ryanstevensmith/locust_hardware/IC_002 - Acoustic Nb-IoT Daughter Board/IC_002 - Acoustic Nb-IoT Daughter Board - Release v3.0/back.png

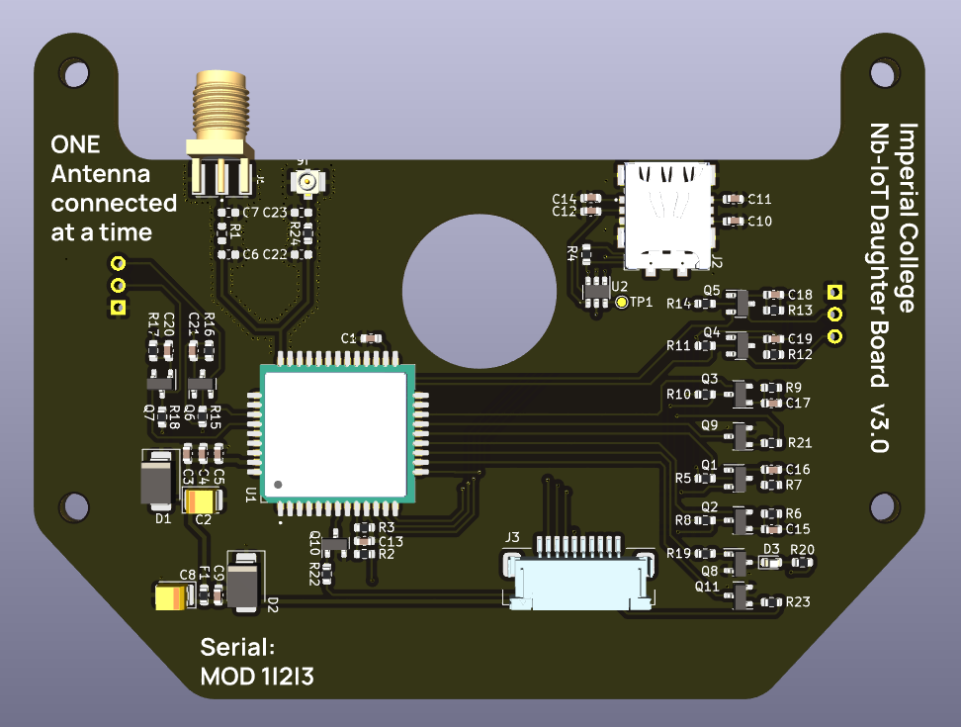
IC_002 - Acoustic Nb-IoT Daughter Board/IC_002 - Acoustic Nb-IoT Daughter Board - Release v3.0/back.png
