ryanstevensmith/locust_hardware/IC_001 - Low Cost Audio Sensor/IC_001 - Low Cost Audio Sensor - Release v3.0/manufacturing files/IC_001 - Low Cost Audio Sensor - BoM EXT - v3.0.csv

Reference | Qty | Value | Footprint | LCSC | MF | MP | Digi-Key
C1,C4,C7,C8,C13,C22,C23,C24,C25,C27,C28 | 11 | 100nF | Capacitor_SMD:C_0402_1005Metric | C1525 | Murata Electronics | GRM155R71C104KA88J | 490-6328-2-ND
C2,C3,C5,C6,C16,C17,C18,C20,C21,C26 | 10 | 10uF | Capacitor_Tantalum_SMD:CP_EIA-3216-18_Kemet-A | C128254 | KEMET | T491A106K010AT | 399-3684-2-ND
C14 | 1 | 10n | Capacitor_SMD:C_0402_1005Metric | C1524 | Murata Electronics | GRM155R71C103KA01D | 490-1313-2-ND
C15 | 1 | 2u2 | Capacitor_SMD:C_0402_1005Metric | C193620 | Murata Electronics | GRM155R61E225ME11D | 490-12704-2-ND
D1,D2,D9,D10,D11,D12,D13,D14,D15,D16,D17,D18,D19,D20,D21,D22,D23,D24,D25,D26,D27,D28,D29,D30,D31,D32,D33,D34,D35,D36,D37,D38,D39,D40,D41,D49,D50,D51,D52,D53 | 40 | SK6806 - j | SR_LED:LED_SK6805_PLCC4_2.4x2.7mm_P1.3mm | C2909056 |  | SK6805MICRO-J
D3 | 1 | BZT52C6V8LP-7 | SR_Package_DFN_QFN:X1-DFN1006-2 | C460796 | Diodes Incorporated | BZT52C6V8LP-7 | BZT52C6V8LPDITR-ND
D4,D5,D6,D7,D8,D42,D43,D44,D45,D46,D47,D48 | 12 | ESD761 | SR_Package_SON:Texas_DPY0002A_0.6x1mm_P0.65mm | C20345399 | Texas Instruments | ESD761DPYRQ1 | 296-ESD761DPYRQ1TR-ND
F1,F2 | 2 | 1A/6V | Fuse:Fuse_0603_1608Metric | C516069 | Littelfuse Inc. | 0603L100SLYR | F5761TR-ND
J1 | 1 | USB4115-03-C | SR_Connectors:USB_C_Receptacle_GCT_USB4115-03-C | C5250720 | GCT | USB4115-03-C | 2073-USB4115-03-CTR-ND
J2 | 1 | JST_SH | SR_Connectors:JST_SH_BM05B-SRSS-TB_1x05-1MP_P1.00mm_Vertical | C160391 | JST | BM05B-SRSS-TB | 455-BM05B-SRSS-TBTR-ND
J3 | 1 | 53261-0371 | Connector_Molex:Molex_PicoBlade_53261-0371_1x03-1MP_P1.25mm_Horizontal | C293630 | Molex | 532610371 | WM7621TR-ND
J4 | 1 | 503398-1892 | SR_Connectors:503398-1892 | C428492 | Molex | 5033981892 | WM11190TR-ND
J6 | 1 | 52207-1060 | SR_Connectors:52207-1060 | C3168739 | Molex | 0522071060 | WM3753TR-ND
J7,J8 | 2 | JST_SH | SR_Connectors:JST_SH_SM04B-SRSS-TB_1x04-1MP_P1.00mm_Horizontal | C160404 | JST | SM04B-SRSS-TB | 455-SM04B-SRSS-TBTR-ND
L1,L3,L4,L6 | 4 | BLM15PX221SN1D | Inductor_SMD:L_0402_1005Metric | C160973 | Murata Electronics | BLM15PX221SN1D | 490-11021-2-ND
L2,L5 | 2 | 2.2uH | Inductor_SMD:L_Bourns-SRN4018 | C135262 | Bourns Inc. | SRN4018-2R2M | SRN4018-2R2MTR-ND
Q3 | 1 | DMP3013SFV | Package_SON:Diodes_PowerDI3333-8 | C264098 | Diodes Incorporated | DMP3013SFV-7 | DMP3013SFV-7DITR-ND
R1,R4,R6,R7,R9,R10,R12,R13,R14,R18,R19,R27 | 12 | 10K | Resistor_SMD:R_0402_1005Metric | C25744 | Vishay Dale | CRCW040210K0FKED | 541-10.0KLTR-ND
R2,R3 | 2 | 0R | Resistor_SMD:R_0402_1005Metric | C17168 | Vishay Dale | RCG04020000Z0ED | 541-1887-2-ND
R5,R32,R33 | 3 | 47K | Resistor_SMD:R_0402_1005Metric | C25792 | Vishay Dale | CRCW040247K0FKEDC | 541-3966-2-ND
R8,R11,R22 | 3 | 1M | Resistor_SMD:R_0402_1005Metric | C26087 | Vishay Dale | CRCW04021M00FKED | 541-1.00MLTR-ND
R15,R17 | 2 | 180K | Resistor_SMD:R_0402_1005Metric | C25541 | Vishay Dale | CRCW0402180KFKEDC | 541-4071-2-ND
R16 | 1 | 1M6 | Resistor_SMD:R_0402_1005Metric | C57065 | Vishay Dale | CRCW04021M60FKED | 541-1.60MLTR-ND
R23,R24 | 2 | 5K1 | Resistor_SMD:R_0402_1005Metric | C25941 | Vishay Dale | CRCW04025K10FKED | 541-5.10KLTR-ND
R25,R26 | 2 | 22R | Resistor_SMD:R_0402_1005Metric | C25152 | Vishay Dale | CRCW040222R0FKED | 541-22.0LTR-ND
R28 | 1 | 4K7 | Resistor_SMD:R_0402_1005Metric | C25900 | Vishay Dale | CRCW04024K70FKEDC | 541-3963-2-ND
R29 | 1 | 1M8 | Resistor_SMD:R_0402_1005Metric | C473021 | Vishay Dale | CRCW04021M80FKEDC | 541-4800-2-ND
R34 | 1 | 220R | Resistor_SMD:R_0402_1005Metric | C25151 | Vishay Dale | CRCW0402220RFKEDC | 541-4064-2-ND
SW1,SW2 | 2 | SW_Push | Button_Switch_SMD:SW_SPST_B3U-1000P | C231329 | Omron | B3U-1000P | SW1020TR-ND
SW4,SW5,SW6,SW7,SW8 | 5 | TL3305AF260QG | SR_Button:SW_SPST_TL3305A | C2886902 | E-Switch | TL3305AF260QG | EG5353TR-ND
U1 | 1 | BQ21080 | SR_Package_BGA:Texas_DSBGA-8-1.6mmx1mm_P0.4mm | C6869615 | Texas Instruments | BQ21080YBGR | 296-BQ21080YBGRTR-ND
U2 | 1 | BQ27427 | SR_Package_BGA:Texas_DSBGA-9-1.6mmx1.6_P0.5mm | C6075475 | Texas Instruments | BQ27427YZFR | 296-BQ27427YZFRTR-ND
U3 | 1 | ESP32-S3-WROOM-1 | RF_Module:ESP32-S3-WROOM-1 | C2913202 | Espressif Systems | ESP32-S3-WROOM-1-N16R8 | 5407-ESP32-S3-WROOM-1-N16R8TR-ND
U4,U10 | 2 | TPS63000 | Package_SON:Texas_DRC0010J_ThermalVias | C24966 | Texas Instruments | TPS63000DRCR | 296-19641-2-ND
U5 | 1 | SPV0142LR5H | SR_Sensor_Audio:SPV0142LR5H-1 | C45062176 | Syntiant | SPV0142LR5H-1 | SPV0142LR5HTR-ND
U11 | 1 | TLV320ADC3101IRGER | Package_DFN_QFN:QFN-24-1EP_4x4mm_P0.5mm_EP2.8x2.8mm | C162409 | Texas Instruments | TLV320ADC3101IRGER | 296-39263-2-ND
U13 | 1 | OPA1671IDBVR | Package_TO_SOT_SMD:TSOT-23-5 | C1849409 | Texas Instruments | OPA1671IDBVR | 296-OPA1671IDBVRTR-ND
