ryanstevensmith/locust_hardware/IC_002 - Acoustic Nb-IoT Daughter Board/IC_002 - Acoustic Nb-IoT Daughter Board - Release v3.0/manufacturing files/IC_002 - Acoustic Nb-IoT Daughter Board - BoM EXT - v3.0.csv

Qty | Reference | Value | Footprint | Datasheet | MF | PN | DigiKey
1 | C1 | 2.2uF | Capacitor_SMD:C_0603_1608Metric | ~ | Murata Electronics | GRM188C71C225KE11D | 490-12731-2-ND
2 | C2,C8 | 100uF | Capacitor_Tantalum_SMD:CP_EIA-3528-21_Kemet-B | ~ | KYOCERA AVX | TAJB107M006RNJ | 478-3877-2-ND
4 | C3,C9,C13,C14 | 100nF | Capacitor_SMD:C_0603_1608Metric | ~ | Murata Electronics | GCM188R71H104KA57J | 490-8020-2-ND
1 | C4 | 100pF | Capacitor_SMD:C_0603_1608Metric | ~ | Murata Electronics | GRM1885C1H101JA01D | 490-1427-2-ND
4 | C5,C10,C11,C12 | 22pF | Capacitor_SMD:C_0603_1608Metric | ~ | Murata Electronics | GRM1885C1H220JA01D | 490-1411-2-ND
7 | C15,C16,C17,C18,C19,C20,C21 | 1nF | Capacitor_SMD:C_0603_1608Metric | ~ | Murata Electronics | GCM188R71H102KA37D | 490-4777-2-ND
2 | D1,D2 | P6SMBJ5.0CA | Diode_SMD:D_SMB | https://diotec.com/request/datasheet/p6smbj65.pdf | Diotec | P6SMBJ5.0CA | 4878-P6SMBJ5.0CATR-ND
1 | D3 | Blue | LED_SMD:LED_0603_1608Metric | ~ | Kingbright | APTD1608VBC/D | 754-1804-2-ND
1 | F1 | 1A/32V | Fuse:Fuse_0603_1608Metric | ~ | Panasonic | P15124TR-ND | P15124TR-ND
1 | J1 | SMA | SR_Antenna:CON-SMA-EDGE-S | ~ | RF Solutions | CON-SMA-EDGE-S | CON-SMA-EDGE-S-ND
1 | J2 | 104224-0820 | SR_Connectors:MOLEX_104224-0820 |  | Molex | 104224-0820 | WM23749TR-ND
1 | J3 | 52207-1060 | SR_Connectors:52207-1060 | ~ | Molex | 52207-1060 | WM3753TR-ND
1 | J6 | U.FL | SR_Antenna:U.FL-R-SMT-1_1 | ~ | Hirose Electric Co Ltd | U.FL-R-SMT(10) | H9161TR-ND
11 | Q1,Q2,Q3,Q4,Q5,Q6,Q7,Q8,Q9,Q10,Q11 | BC817 | Package_TO_SOT_SMD:SOT-23 | https://www.onsemi.com/pub/Collateral/BC818-D.pdf | Nexperia | BC817-QR | 1727-BC817-QR-ND
1 | R2 | 21K | Resistor_SMD:R_0603_1608Metric | ~ | Vishay Dale | CRCW060321K0FKEA | 541-21.0KHTR-ND
9 | R3,R4,R5,R8,R10,R11,R14,R15,R18 | 10K | Resistor_SMD:R_0603_1608Metric | ~ | Vishay Dale | CRCW060310K0FKEA | 541-10.0KHTR-ND
7 | R6,R7,R9,R12,R13,R16,R17 | 4K7 | Resistor_SMD:R_0603_1608Metric | ~ | Vishay Dale | CRCW06034K70FKEAC | 541-5454-2-ND
5 | R19,R20,R21,R22,R23 | 1K | Resistor_SMD:R_0603_1608Metric | ~ | Vishay Dale | CRCW06031K00FKEA | 541-1.00KHTR-ND
1 | R24 | 0R | Resistor_SMD:R_0603_1608Metric | ~ | Vishay Dale | CRCW06030000Z0EA | 541-0.0GTR-ND
1 | U1 | BC65 | SR_RF_Module:BC65 | https://www.quectel.com/product/lpwa-bc65-nb-iot/ | Quectel | BC65PB-04-STD | 2958-BC65PB-04-STDTR-ND
1 | U2 | SRV05-4HTG-D | SR_Package_SOT:TSOT-23-6 | https://www.littelfuse.com/assetdocs/littelfuse-tvs-diode-array-srv05-4htg-d-datasheet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 | LittleFuse | SRV05-4HTG-D | SRV05-4HTG-DTR-ND
