ryanstevensmith/locust_hardware/IC_001 - Low Cost Audio Sensor/IC_001 - Low Cost Audio Sensor - Release v3.0/back.png

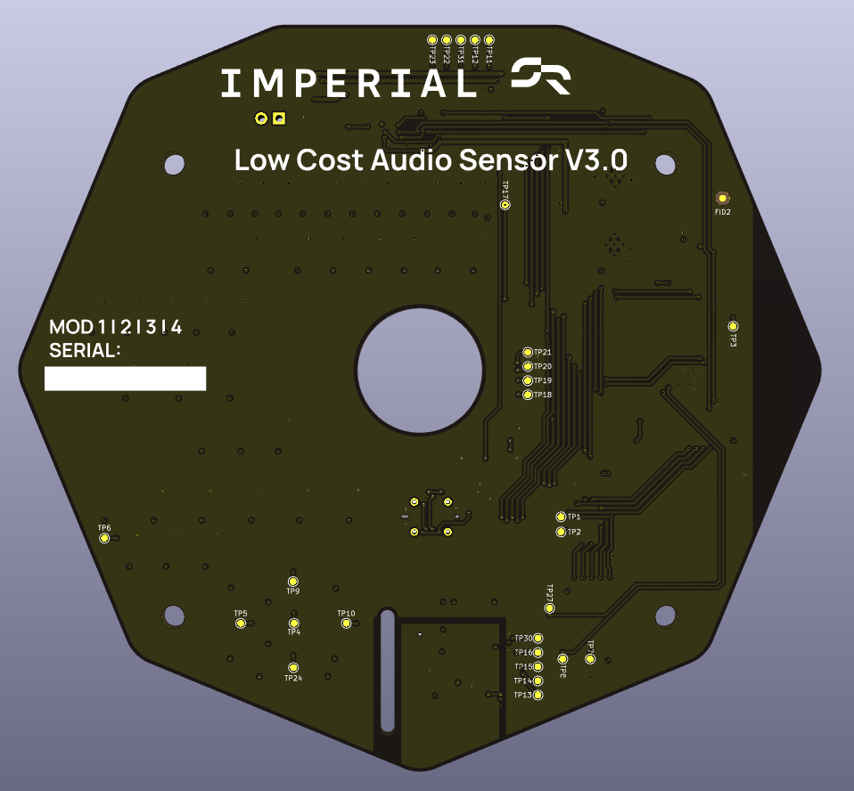
IC_001 - Low Cost Audio Sensor/IC_001 - Low Cost Audio Sensor - Release v3.0/back.png
