ryanstevensmith/locust_hardware/IC_001 - Low Cost Audio Sensor/IC_001 - Low Cost Audio Sensor - Release v3.0/front.png

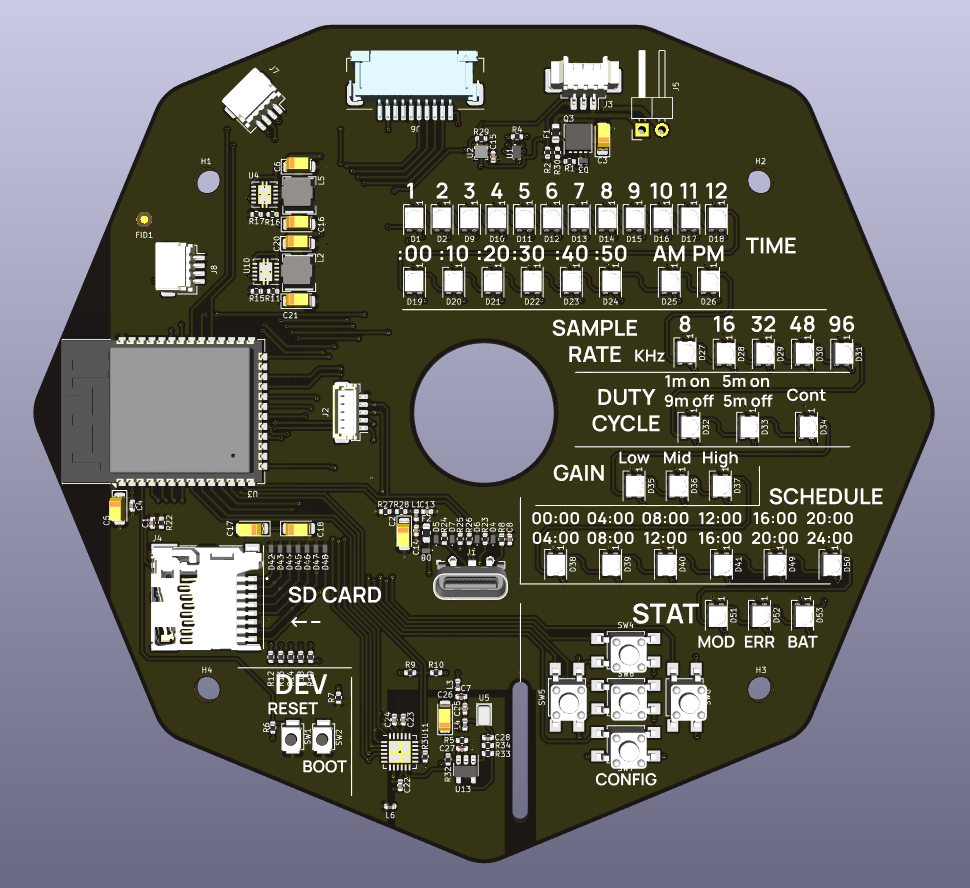
IC_001 - Low Cost Audio Sensor/IC_001 - Low Cost Audio Sensor - Release v3.0/front.png
