ryanstevensmith/locust_hardware/IC_001 - Low Cost Audio Sensor/IC_001 - Low Cost Audio Sensor - Release v3.0/IC_001 - Low Cost Audio Sensor - v3.0.step

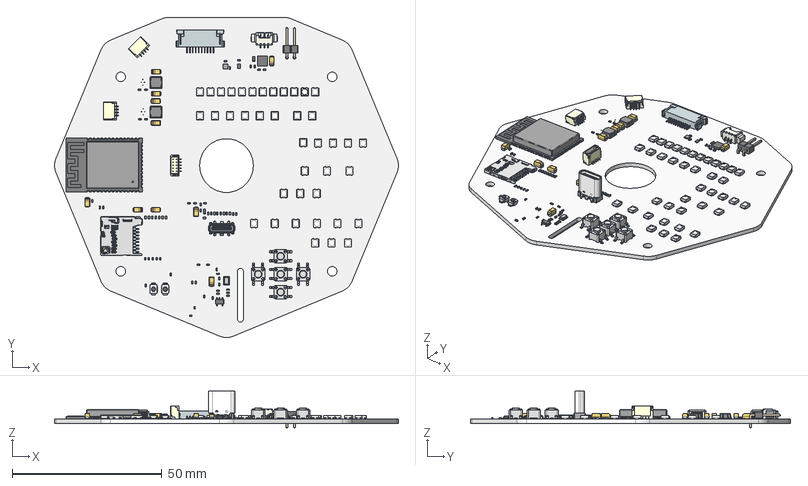
[picture p9: CAD file, 2026-10-24]
IC_001 - Low Cost Audio Sensor/IC_001 - Low Cost Audio Sensor - Release v3.0/IC_001 - Low Cost Audio Sensor - v3.0.step
115.0 x 107.0 x 12.3 mm
R_0402_1005Metric x 31
SPV0142LR5H
TL3305AFxxxxG x 5
DOUT x 40
DIN x 40
VSS x 40
VDD x 40
Texas_DPY0002A_X1SON-2 x 12
LDF
SM04B-SRSS-TB(LF)(SN) x 2
BM05B-SRSS-TB(LF)(SN)
C_0402_1005Metric x 13
USB4115-03-C_PART1
USB4115-03-C_PART2
USB4115-03-C_PART3
USB4115-03-C_PART4
USB4115-03-C_PART5
USB4115-03-C_PART6
USB4115-03-C_PART7
USB4115-03-C_PART8
USB4115-03-C_PART9
USB4115-03-C_PART10
USB4115-03-C_PART11
USB4115-03-C_PART12
USB4115-03-C_PART13
USB4115-03-C_PART14
USB4115-03-C_PART15
USB4115-03-C_PART16
USB4115-03-C_PART17
USB4115-03-C_PART18
USB4115-03-C_PART19
USB4115-03-C_PART20
USB4115-03-C_PART21
USB4115-03-C_PART22
USB4115-03-C_PART23
USB4115-03-C_PART24
USB4115-03-C_PART25
USB4115-03-C_PART26
USB4115-03-C_PART27
USB4115-03-C_PART28
USB4115-03-C_PART29
USB4115-03-C_PART30
USB4115-03-C_PART31
USB4115-03-C_PART32
USB4115-03-C_PART33
USB4115-03-C_PART34
USB4115-03-C_PART35
USB4115-03-C_PART36
USB4115-03-C_PART37
USB4115-03-C_PART38
USB4115-03-C_PART39
USB4115-03-C_PART40
USB4115-03-C_PART41
USB4115-03-C_PART42
USB4115-03-C_PART43
USB4115-03-C_PART44
ESP32-S3-WROOM-1
PinHeader_1x02_P2.54mm_Horizontal
CP_EIA-3216-18_Kemet-A x 10
DSBGA8-YBG_TEX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
