ryanstevensmith/locust_hardware/IC_002 - Acoustic Nb-IoT Daughter Board/IC_002 - Acoustic Nb-IoT Daughter Board - Release v3.0/IC_002 - Acoustic Nb-IoT Daughter Board - v3.0.step

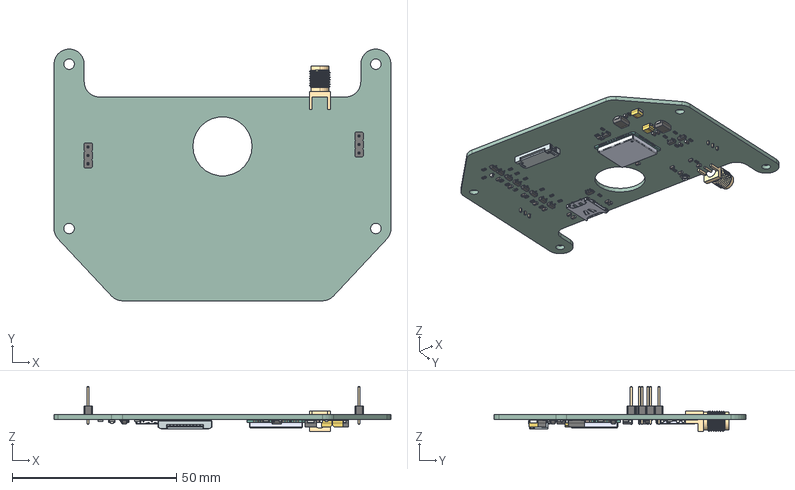
[picture p10: CAD file, 2026-10-24]
IC_002 - Acoustic Nb-IoT Daughter Board/IC_002 - Acoustic Nb-IoT Daughter Board - Release v3.0/IC_002 - Acoustic Nb-IoT Daughter Board - v3.0.step
102.5 x 76.6 x 13.8 mm
PinHeader_1x03_P2.54mm_Vertical x 2
R_0603_1608Metric x 24
SOT-23 x 11
C_0603_1608Metric x 21
Fuse_0603_1608Metric
D_SMB x 2
BC65
CON-SMA-EDGE-S
CP_EIA-3528-21_Kemet-B x 2
U.FL-R-SMT-1
TSOT-23-6
LED_0603_1608Metric
IC_002 - Acoustic Nb-IoT Daughter Board_PCB
