ryanstevensmith/locust_hardware/IC_001 - Low Cost Audio Sensor/IC_001 - Low Cost Audio Sensor - Release v1.0/IC_001 - Low Cost Audio Sensor - v1.0.step

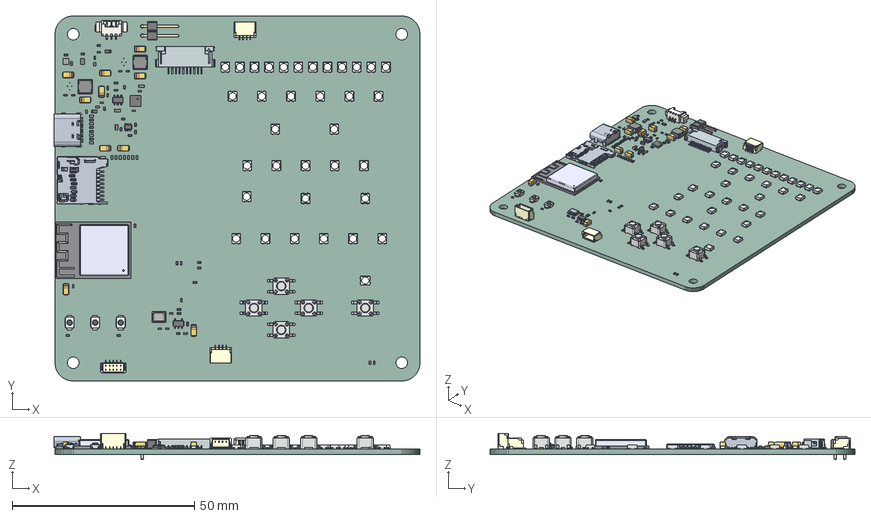
[picture p11: CAD file, 2026-10-24, an earlier design]
IC_001 - Low Cost Audio Sensor/IC_001 - Low Cost Audio Sensor - Release v1.0/IC_001 - Low Cost Audio Sensor - v1.0.step
100.3 x 100.0 x 7.25 mm
IC_001 - Low Cost Audio Sensor PCB
