ryanstevensmith/locust_hardware/IC_002 - Acoustic Nb-IoT Daughter Board/IC_002 - Acoustic Nb-IoT Daughter Board - Release v1.0/IC_002 - Acoustic Nb-IoT - v1.0.step

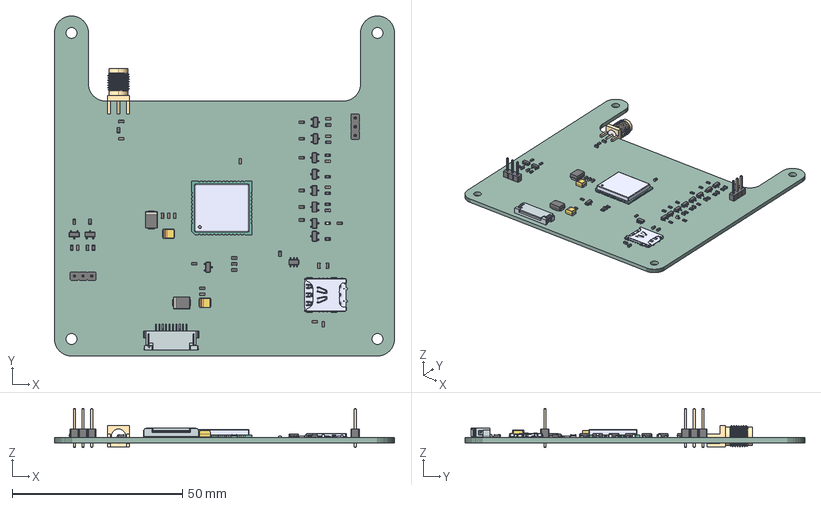
[picture p12: CAD file, 2026-10-24, an earlier design]
IC_002 - Acoustic Nb-IoT Daughter Board/IC_002 - Acoustic Nb-IoT Daughter Board - Release v1.0/IC_002 - Acoustic Nb-IoT - v1.0.step
100.0 x 100.0 x 11.5 mm
IC_002 - Acoustic Nb-IoT Daughter Board PCB
