ryanstevensmith/locust_hardware/IC_001 - Low Cost Audio Sensor/IC_001 - Low Cost Audio Sensor - Release v3.0/IC_001 - Low Cost Audio Sensor - Schematics - v3.0.pdf

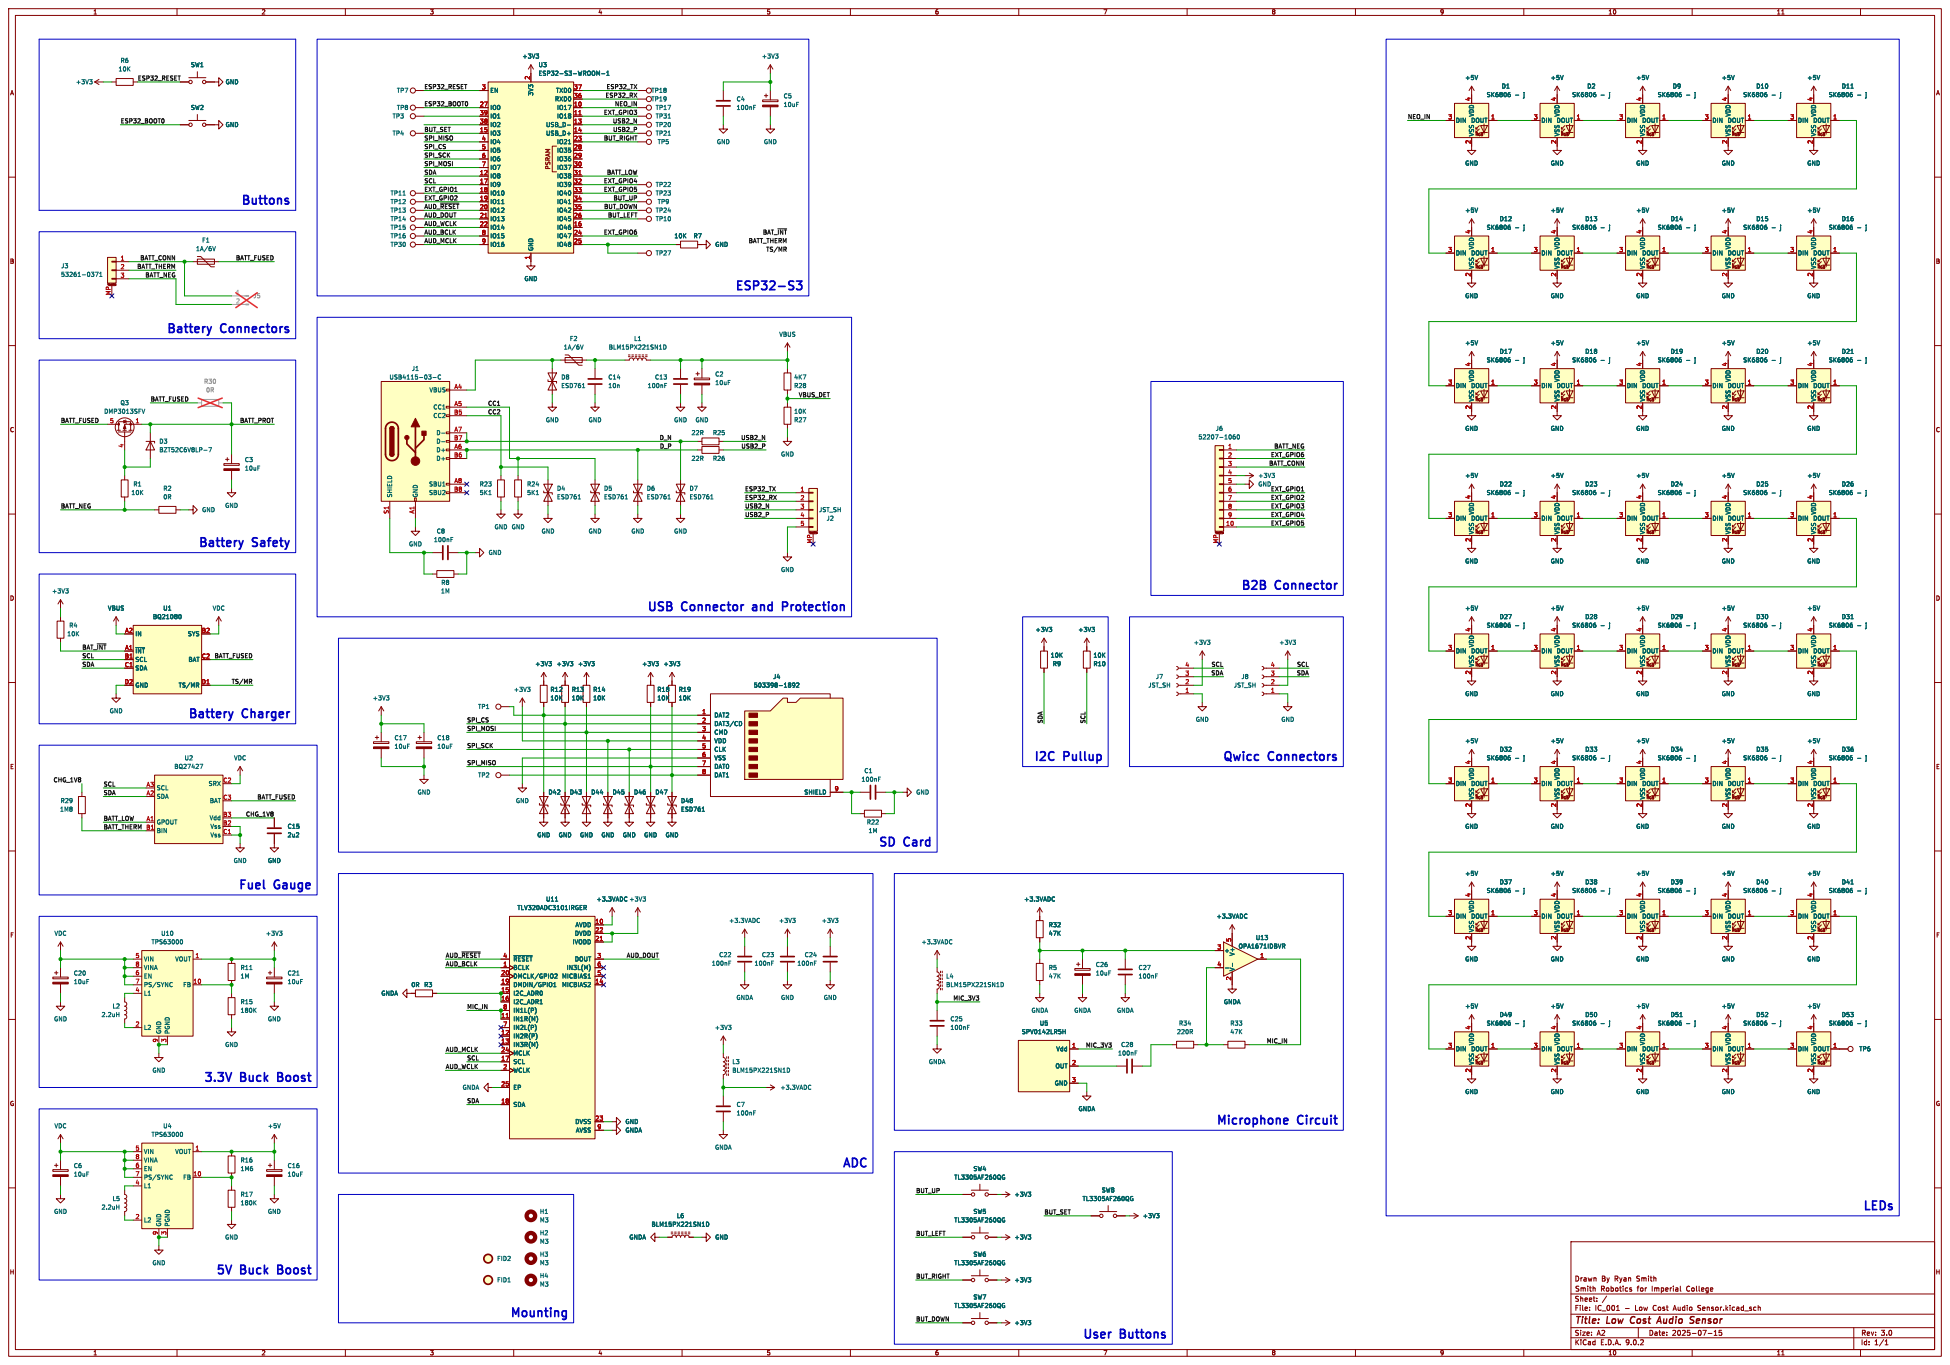
[picture p13: page 1]

USB Connector and Protection

VIN 5 VINA 8 EN 6 PS/SYNC 7

~{RESET} 4 BCLK 1 DMCLK/GPIO2 20 DMDIN/GPIO1 19
