ryanstevensmith/locust_hardware/IC_002 - Acoustic Nb-IoT Daughter Board/IC_002 - Acoustic Nb-IoT Daughter Board - Release v3.0/IC_002 - Acoustic Nb-IoT Daughter Board - Schematics - v3.0.pdf

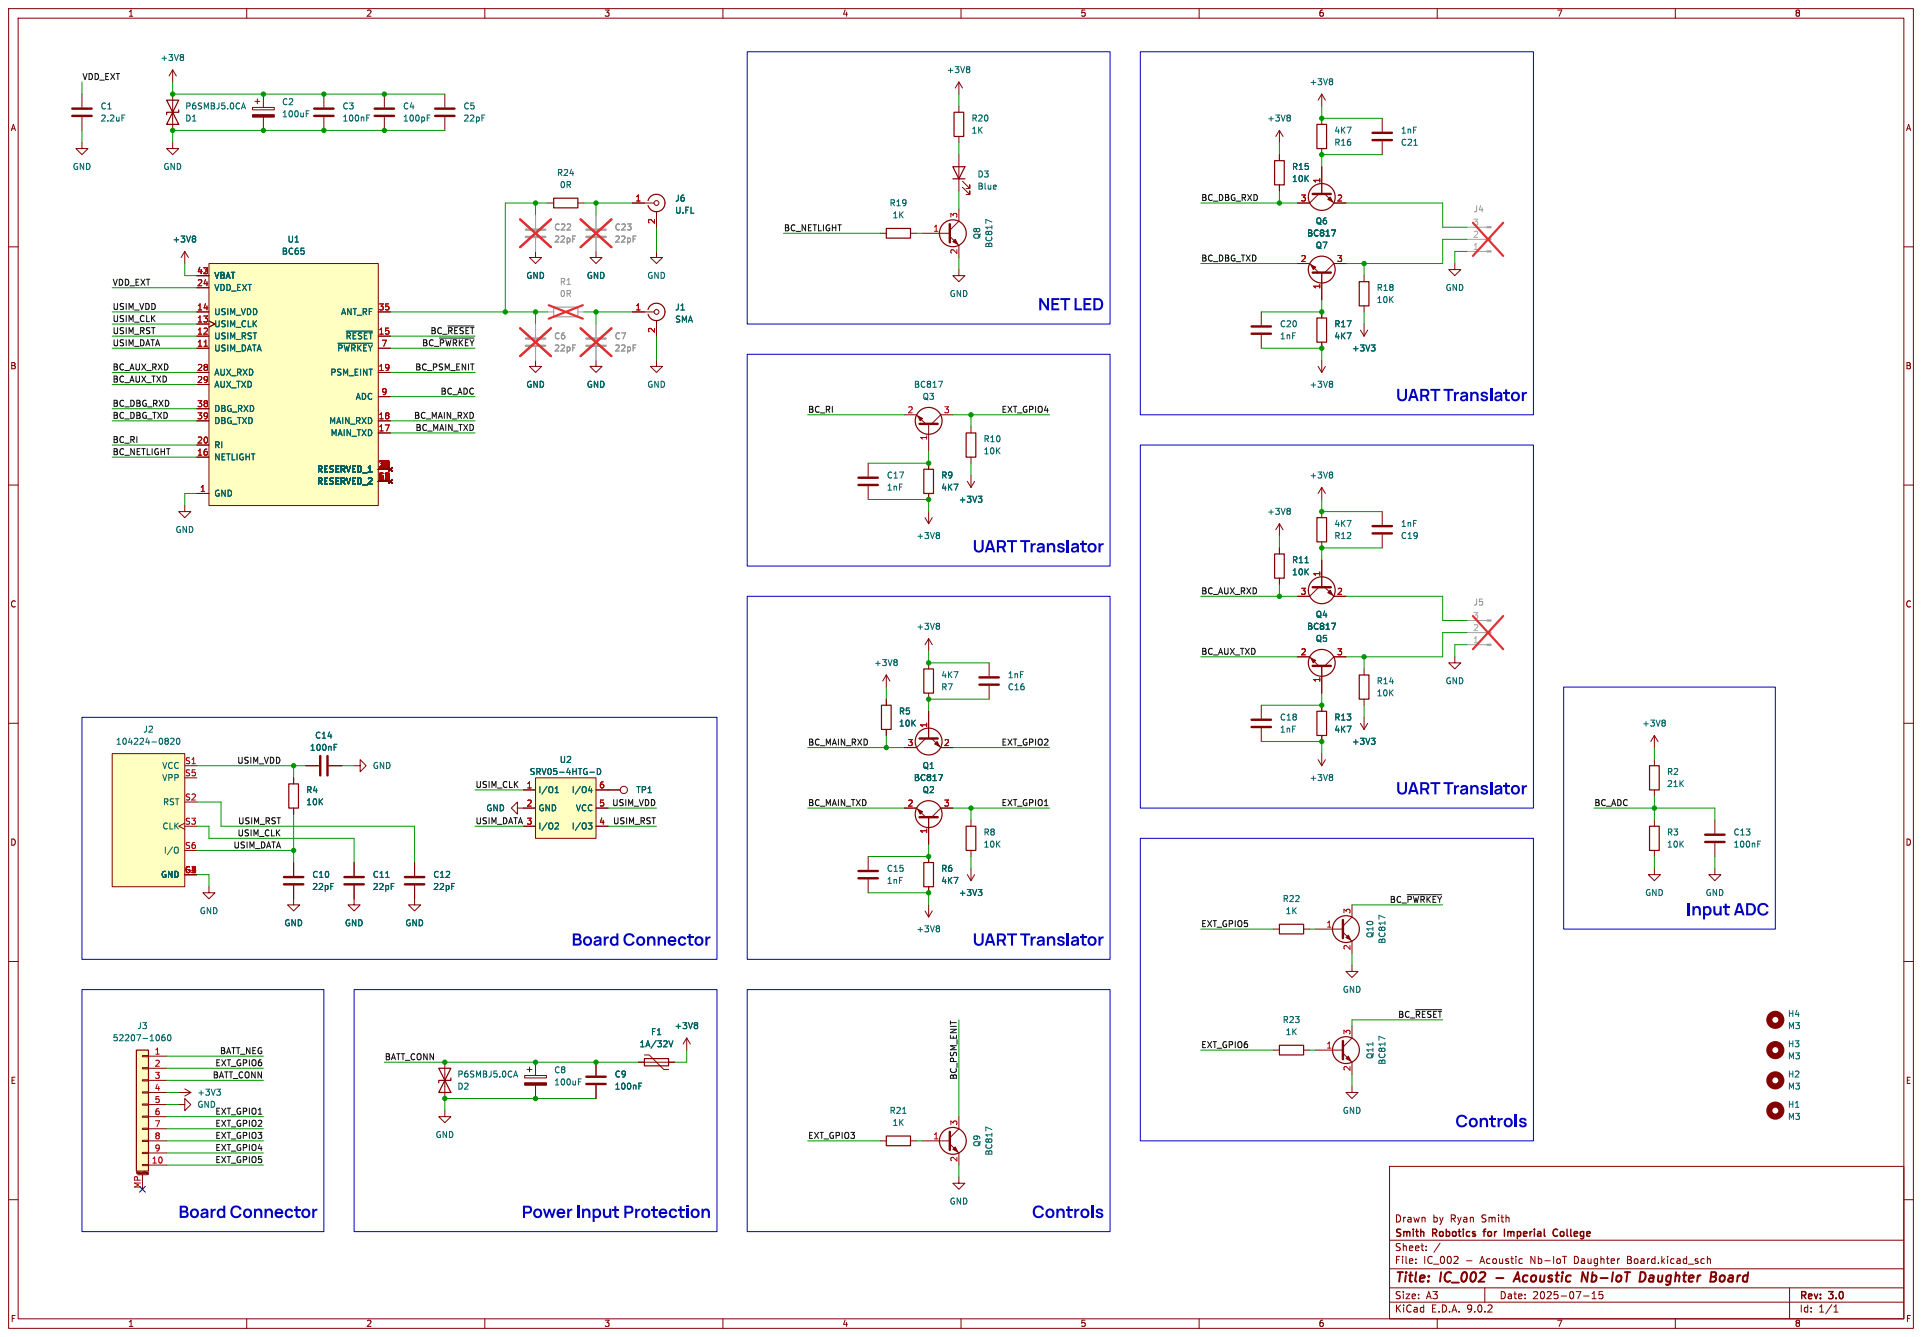
[picture p14: page 1]

Id: 1/1 Title: IC_002 - Acoustic Nb-IoT Daughter Board
