ryanstevensmith/locust_hardware/IC_001 - Low Cost Audio Sensor/IC_001 - Low Cost Audio Sensor - Release v1.0/IC_001 - Low Cost Audio Sensor - Schematics - v1.0.pdf

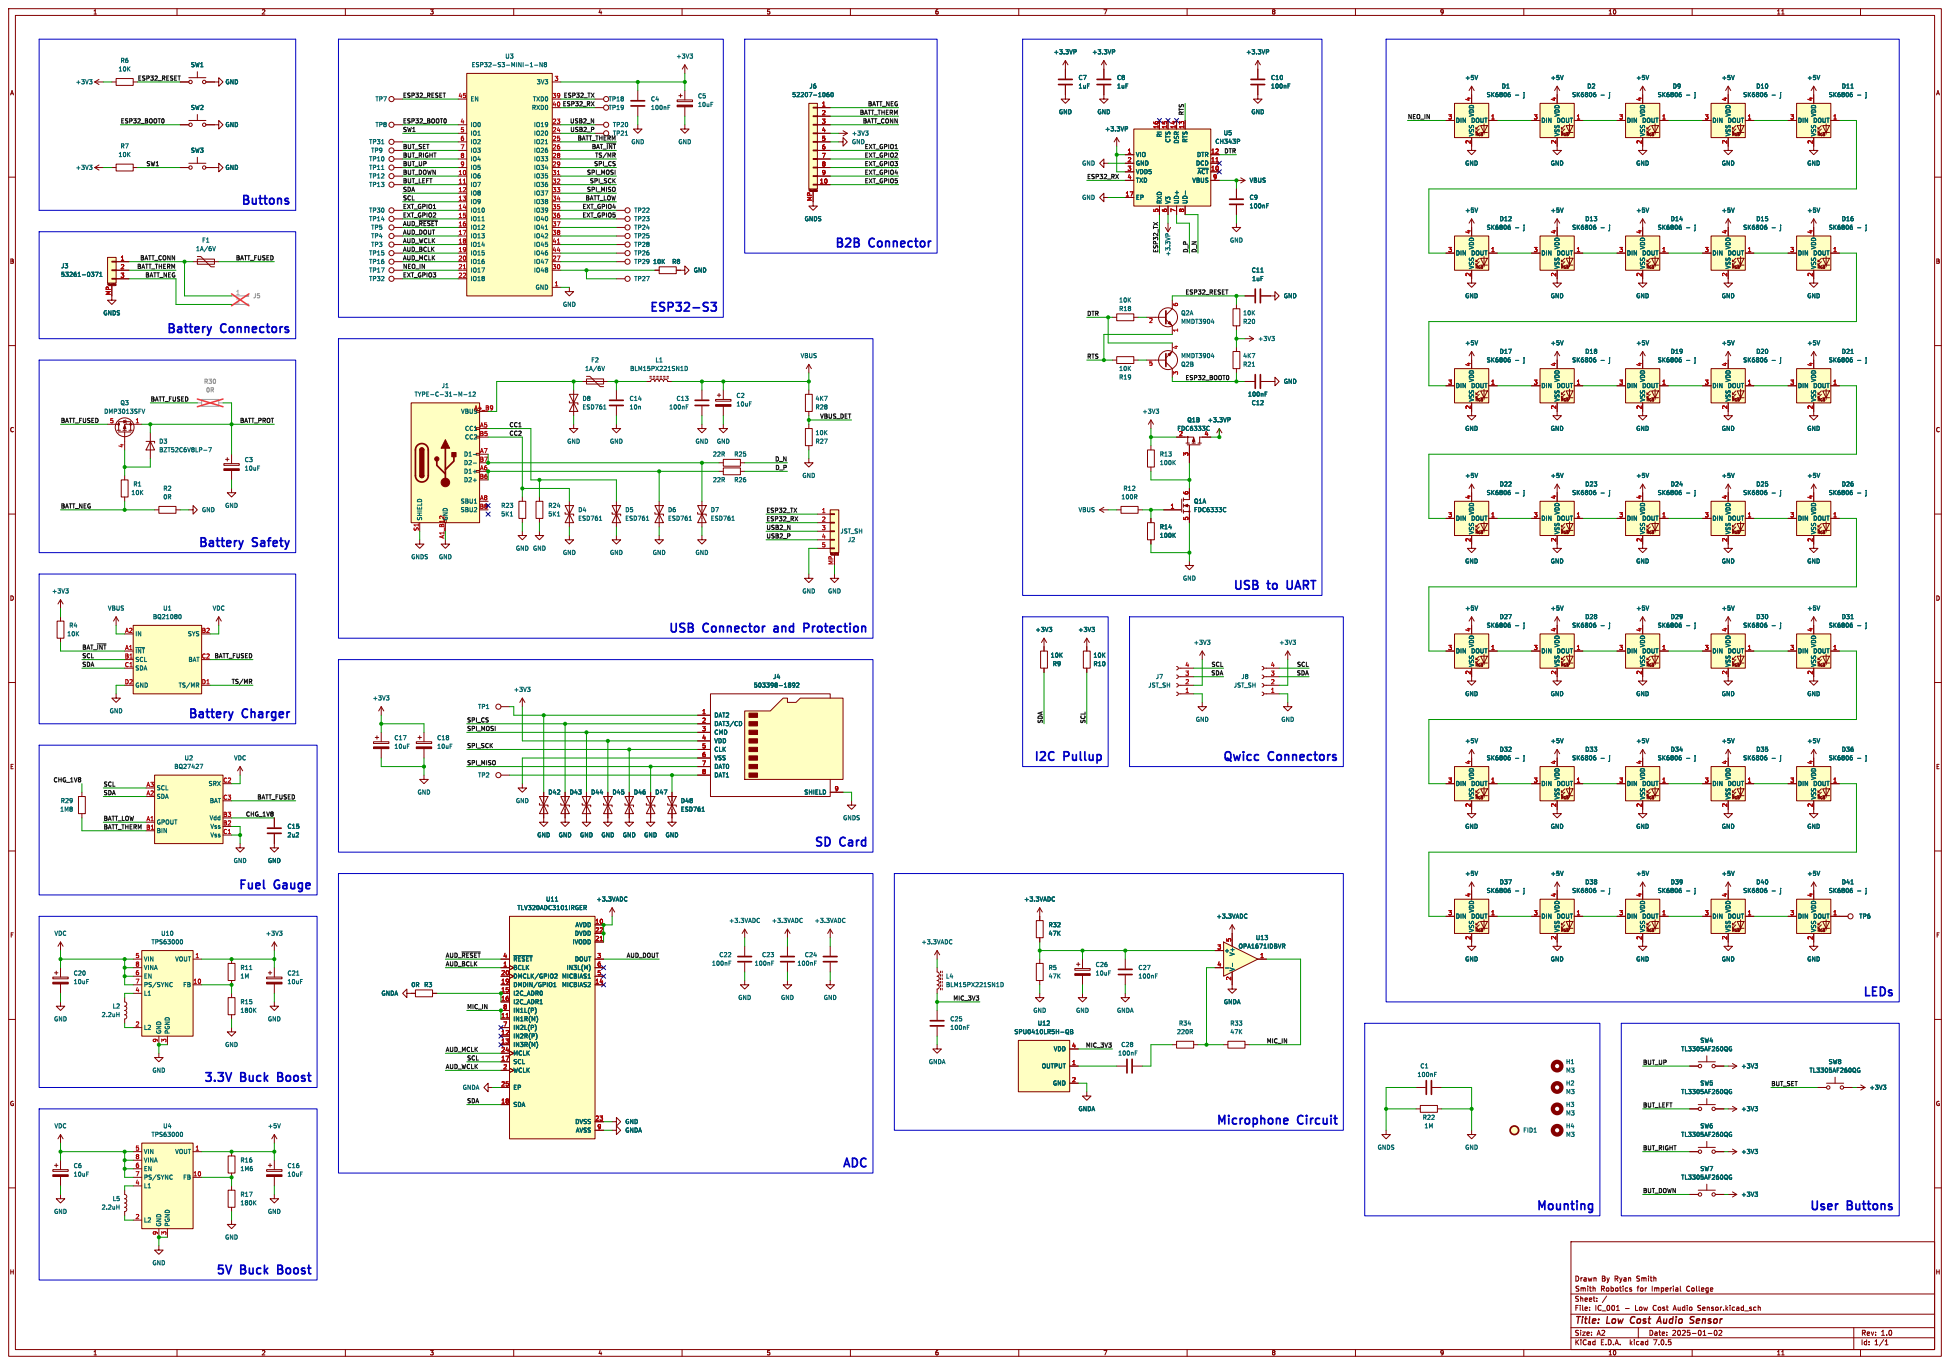
[picture p38: page 1]

USB Connector and Protection

I2C_ADR1 16 SCL 17 SDA 18 DMDIN/GPIO1 19 WCLK 2 DMCLK/GPIO2 20

I2C_ADR0 15
