ryanstevensmith/locust_hardware/IC_002 - Acoustic Nb-IoT Daughter Board/IC_002 - Acoustic Nb-IoT Daughter Board - Release v1.0/IC_002 - Acoustic Nb-IoT - Schematics - v1.0.pdf

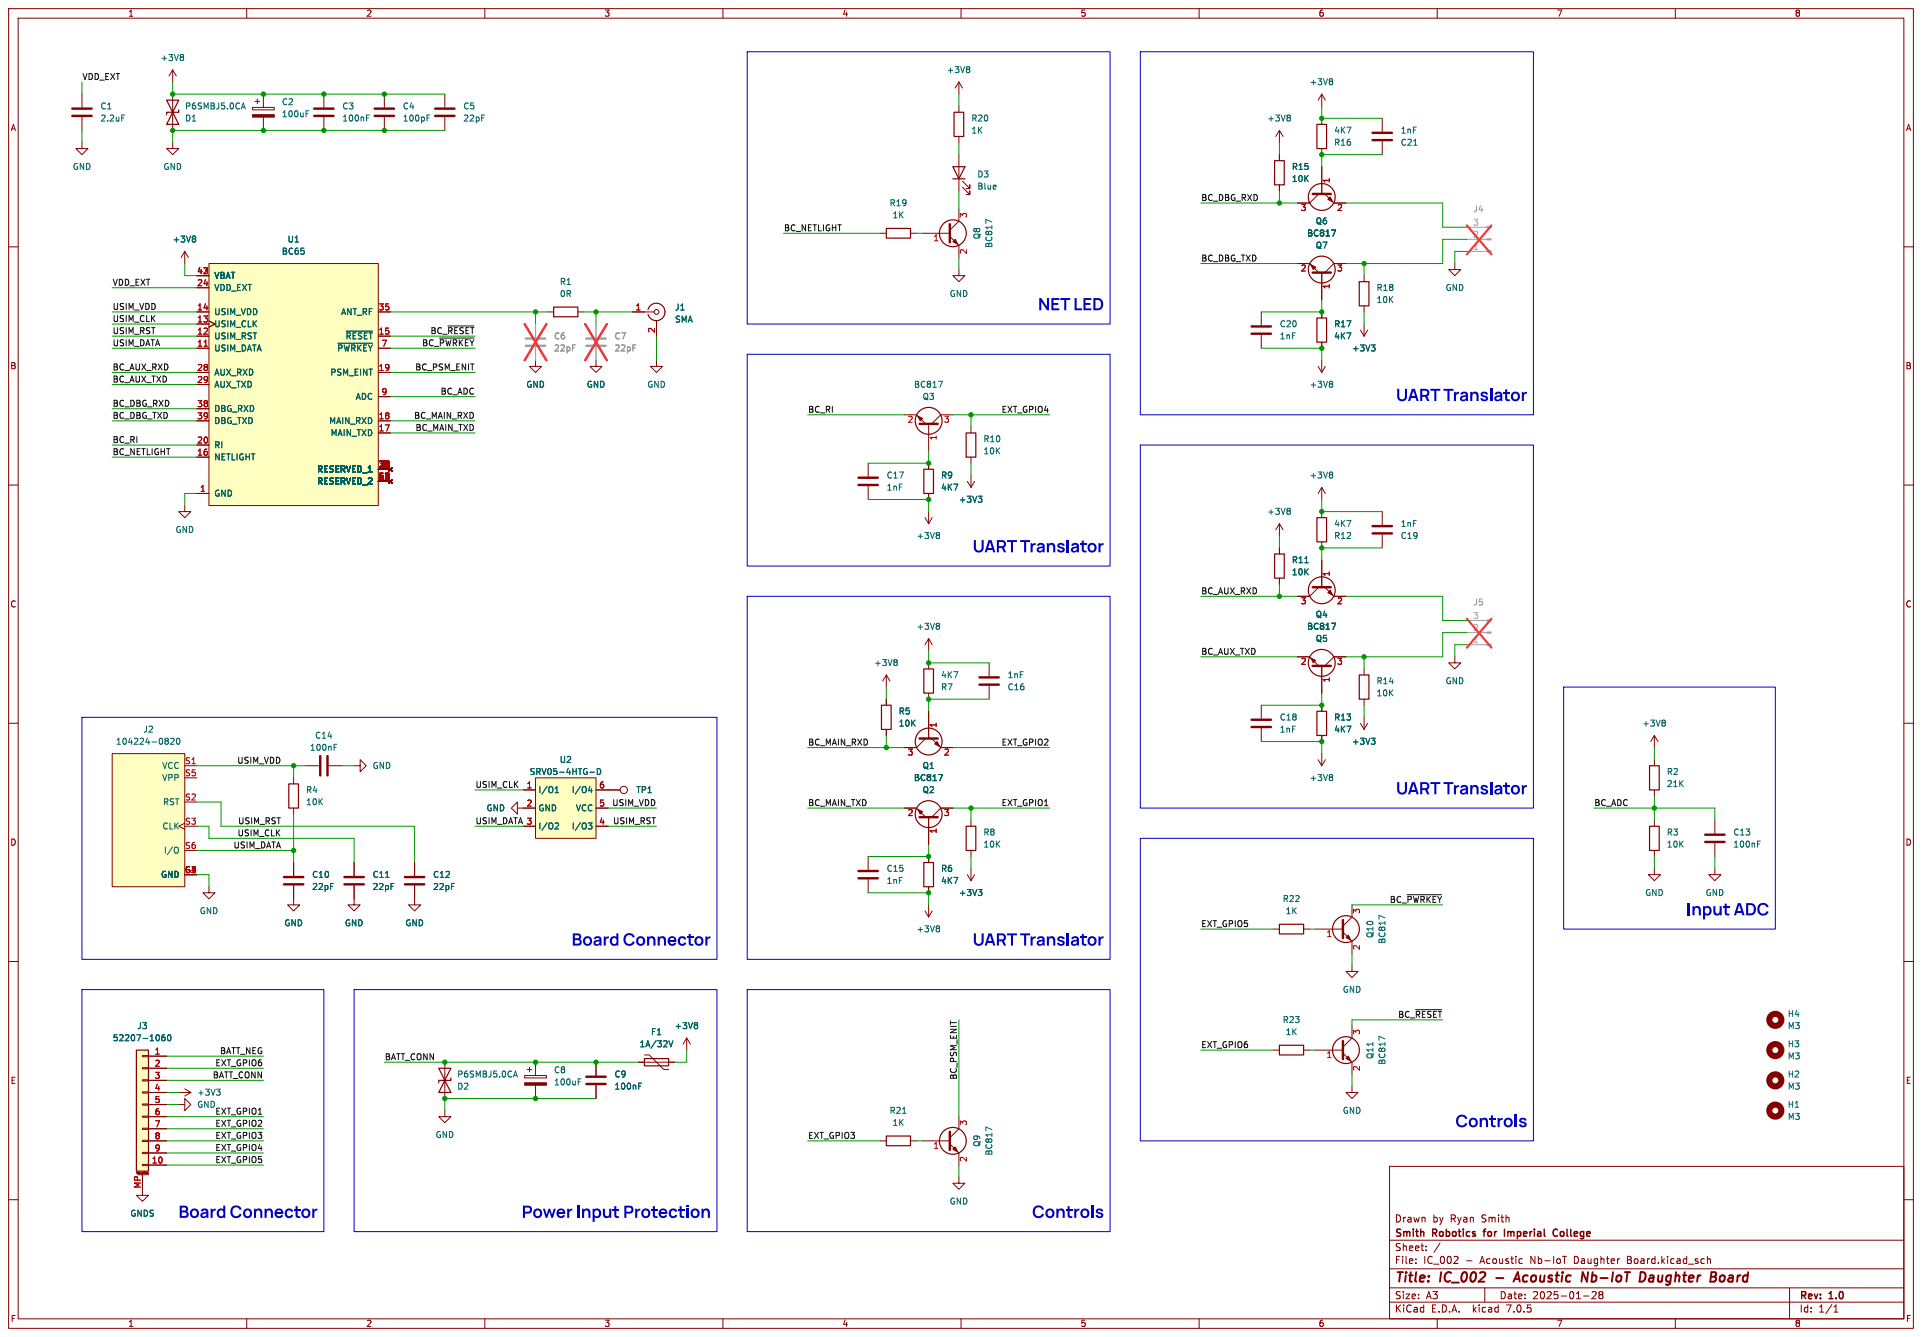
[picture p39: page 1]

10K GND G1234 VCC S1 RST S2 CLK S3 GND S4 VPP S5

Id: 1/1 Title: IC_002 - Acoustic Nb-IoT Daughter Board
