ryanstevensmith/locust_hardware/IC_001 - Low Cost Audio Sensor/IC_001 - Low Cost Audio Sensor - Release v1.0/IC_001 - Low Cost Audio Sensor - Layer Drawings - v1.0.pdf

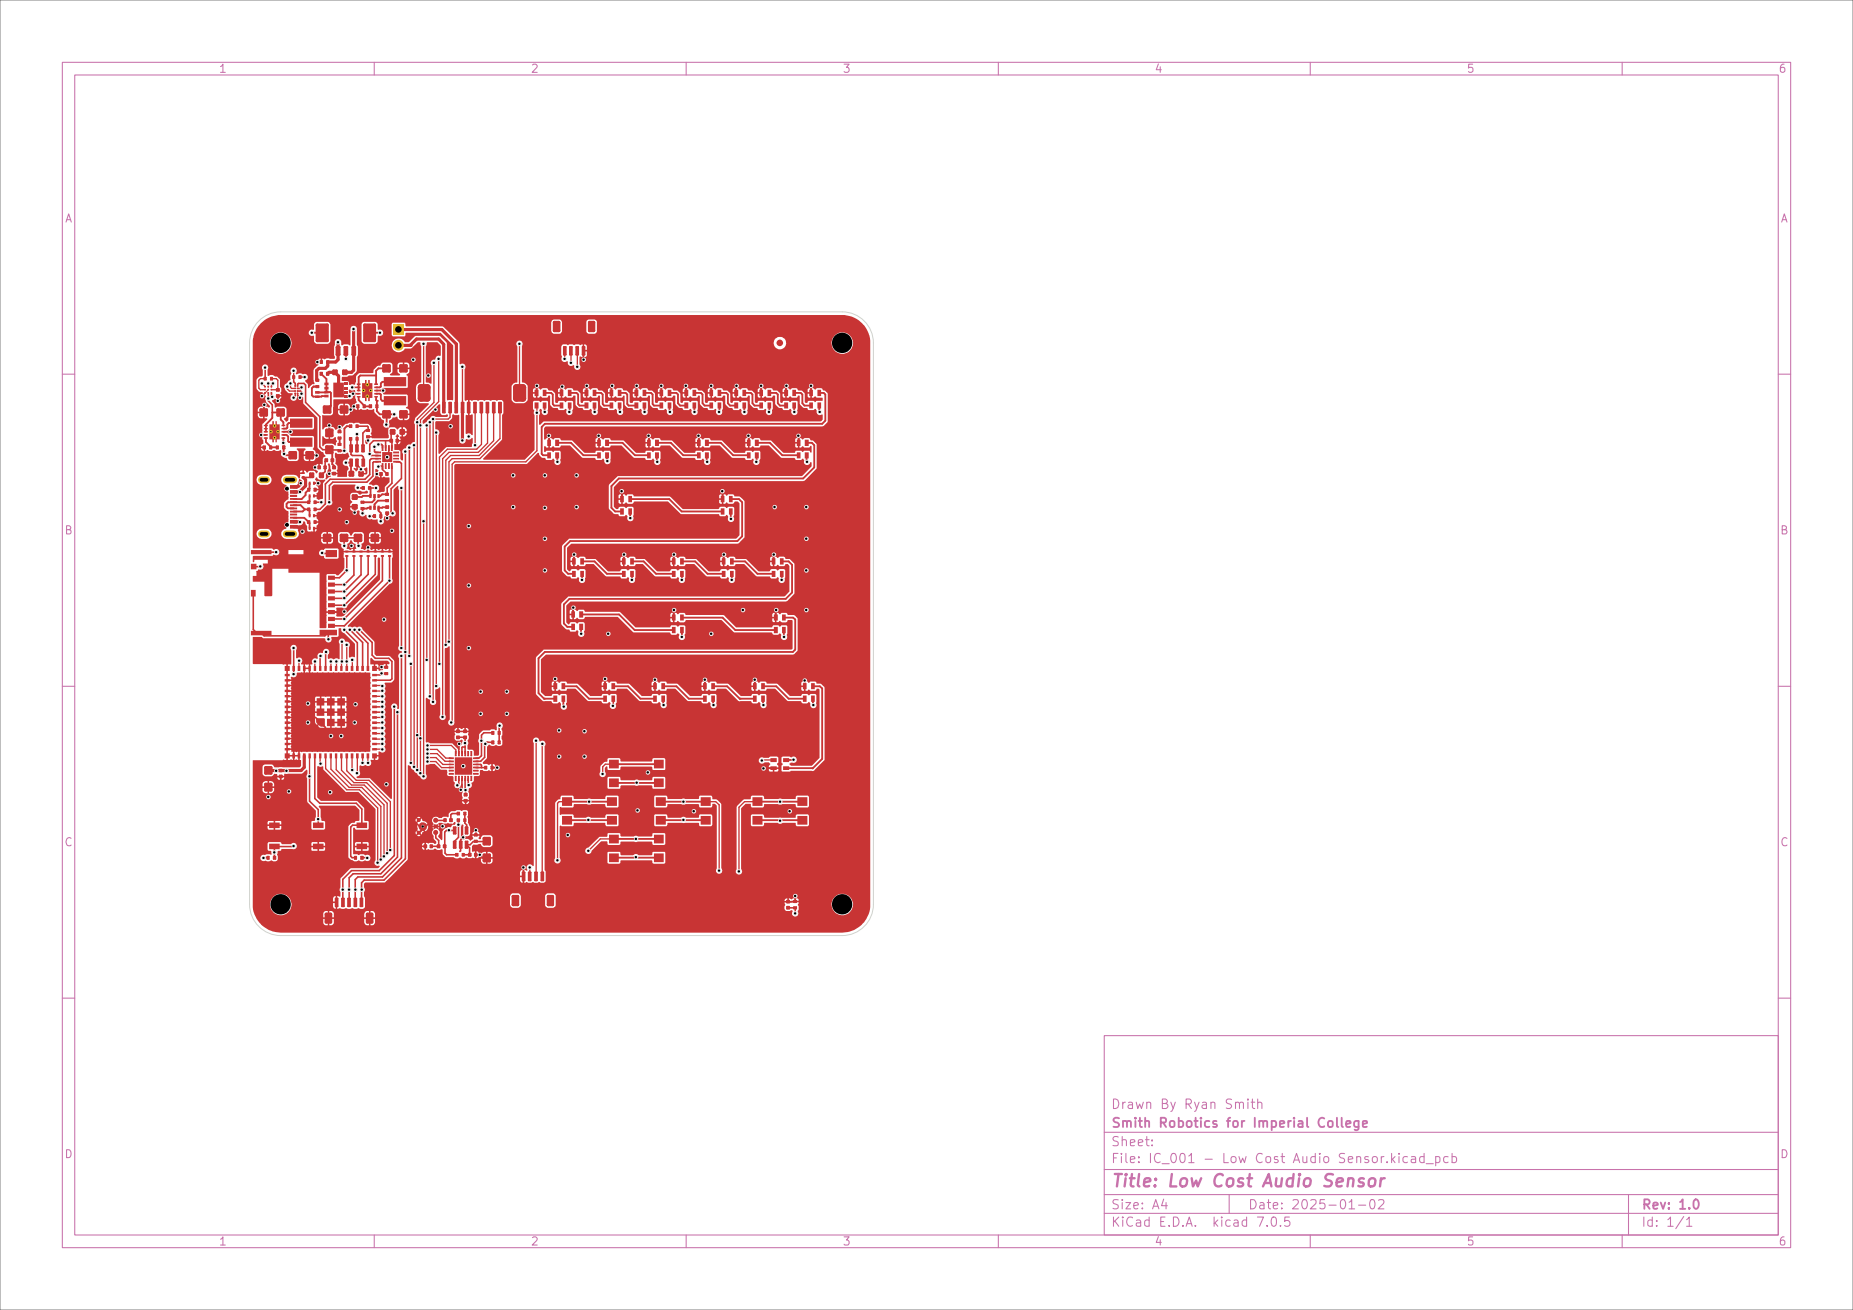
[picture p40: page 1]

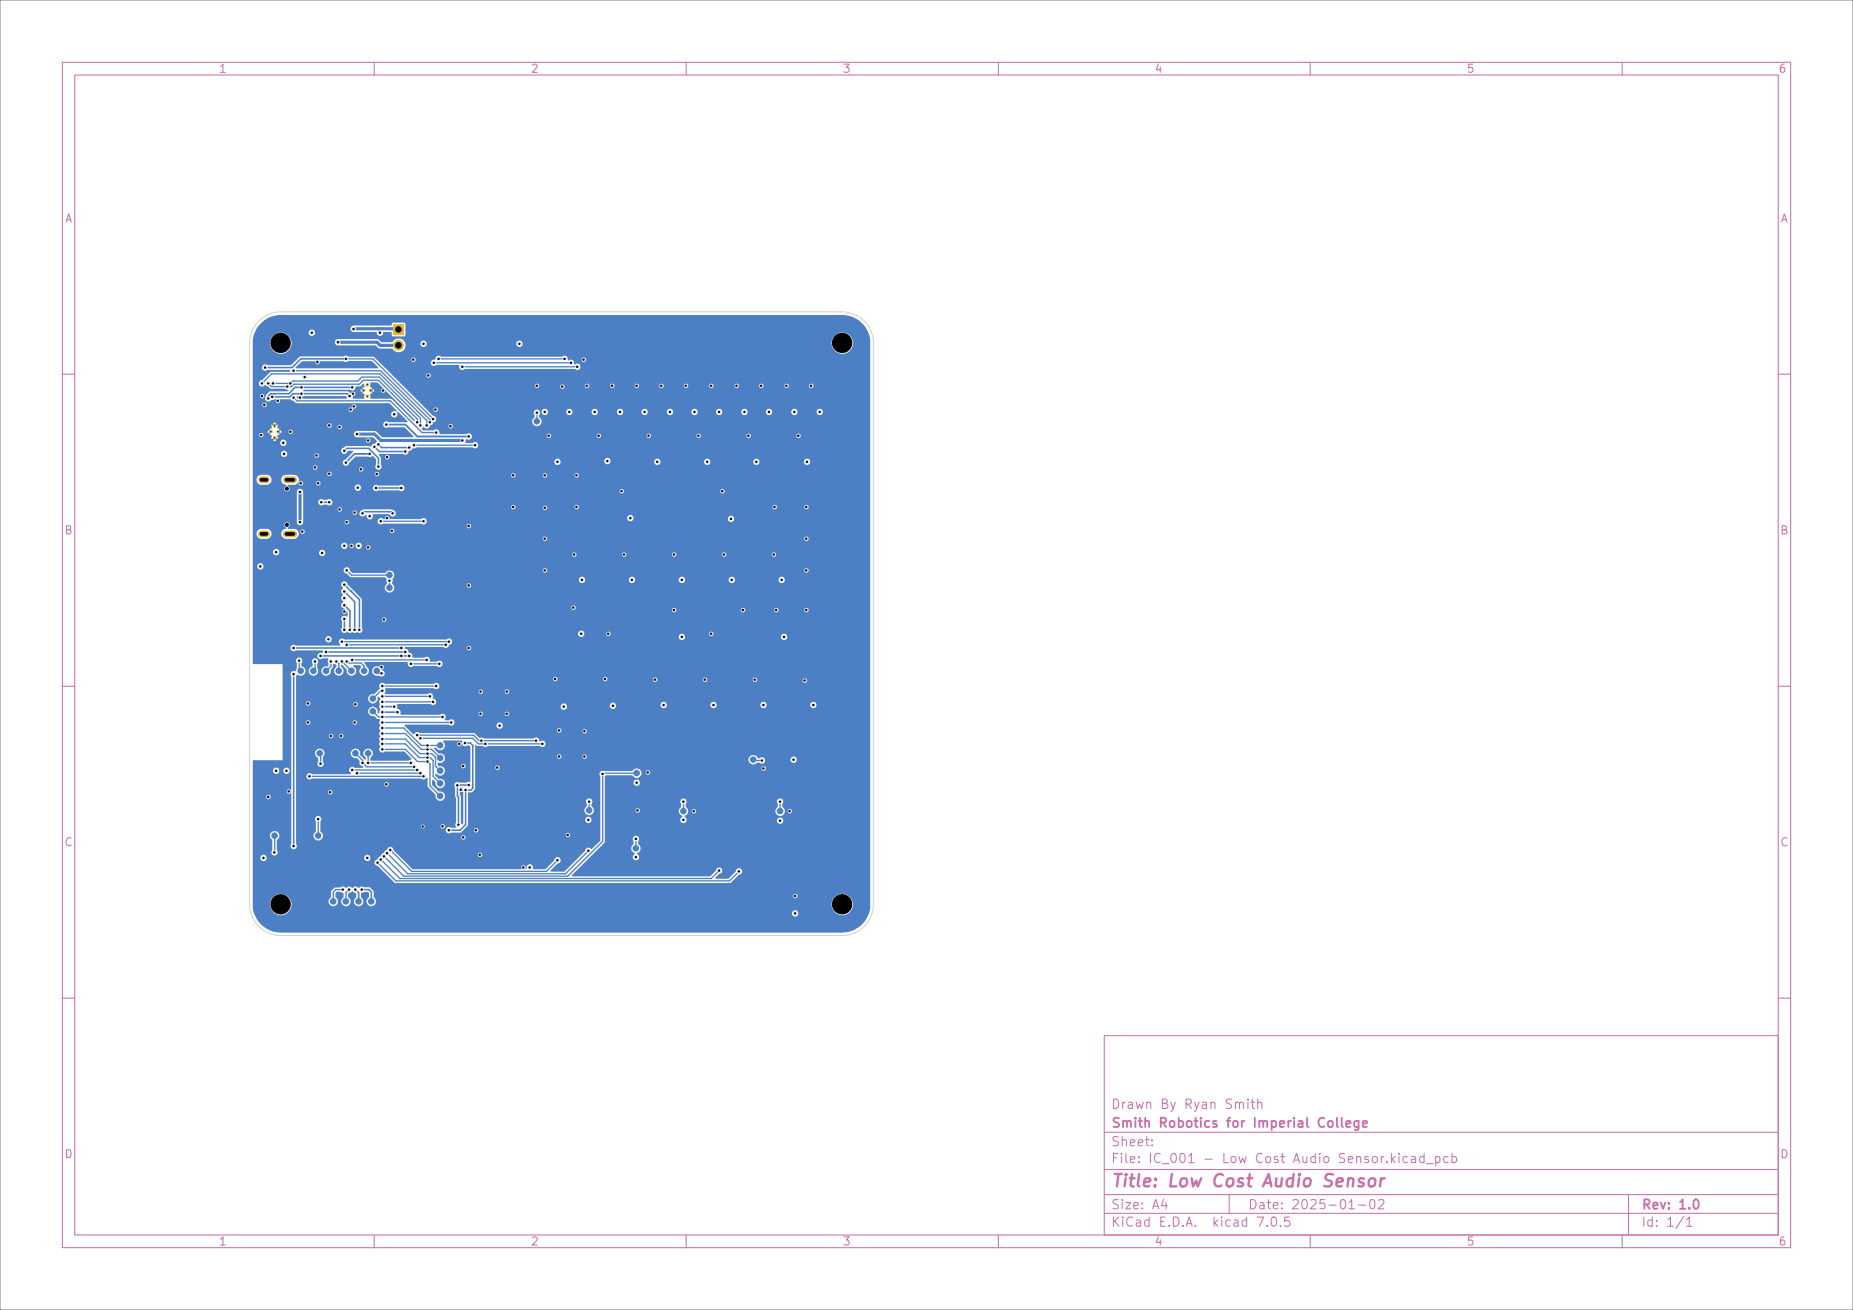
[picture p41: page 2]

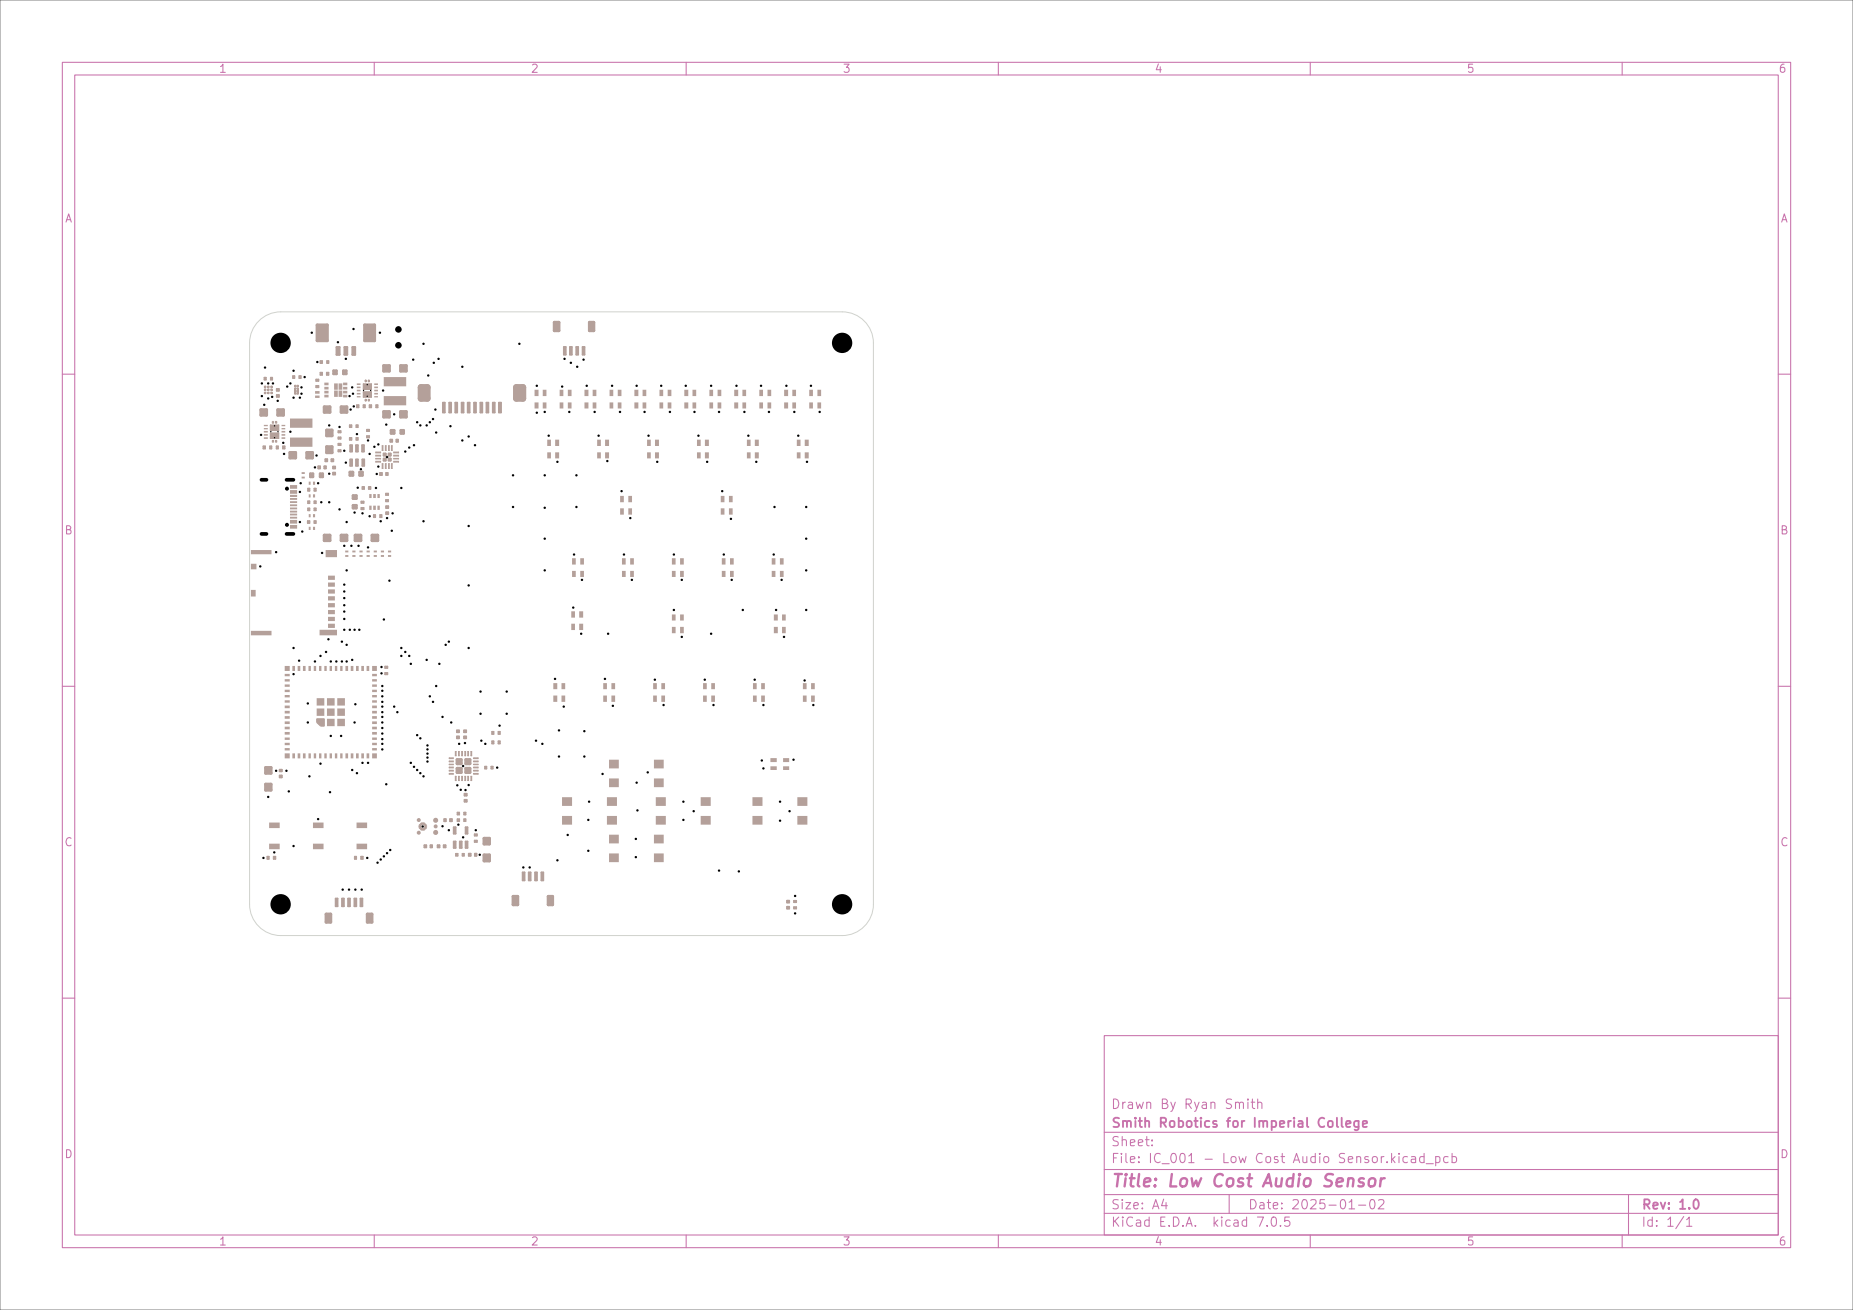
[picture p42: page 3]

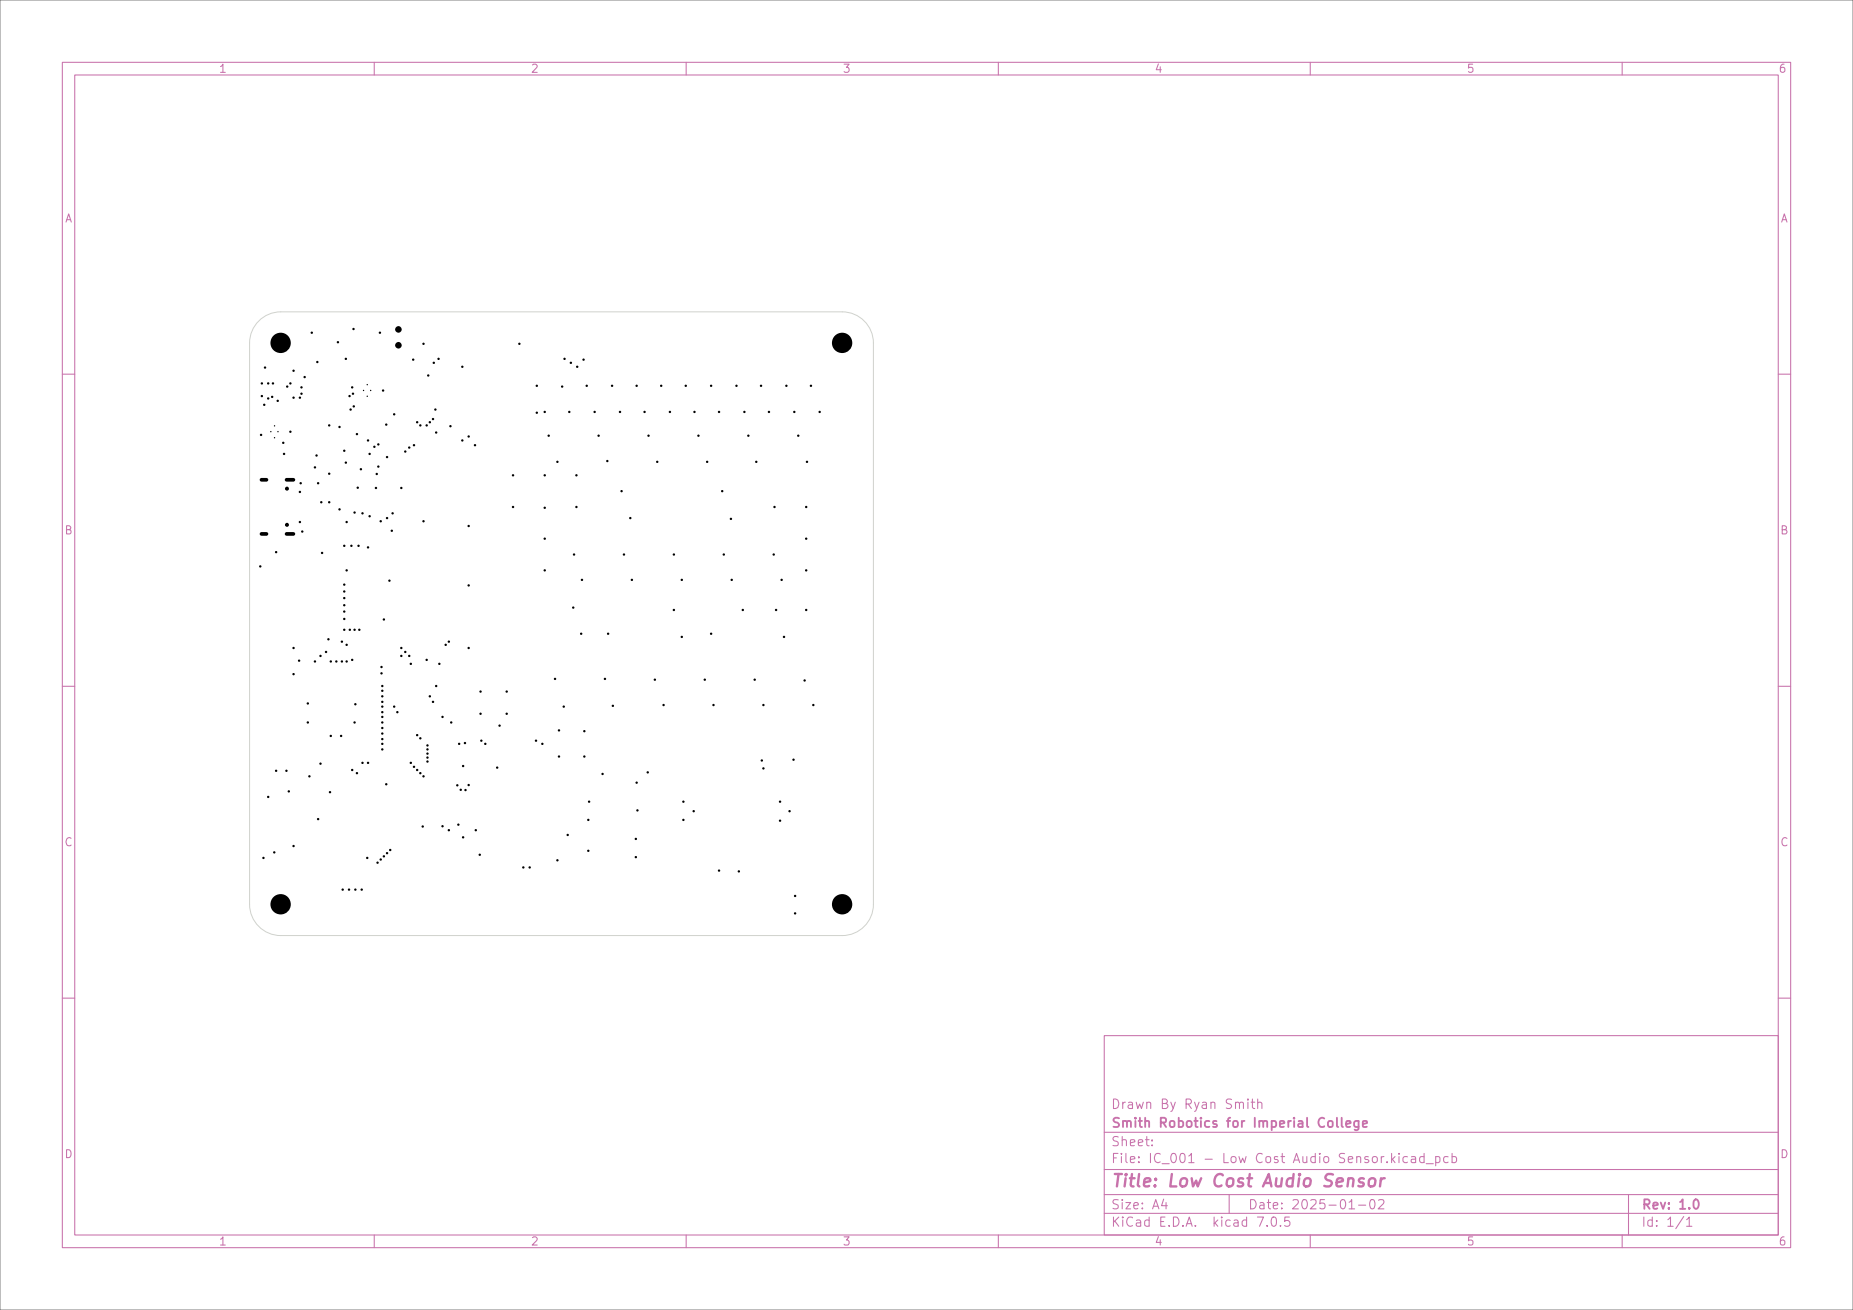
[picture p43: page 4]

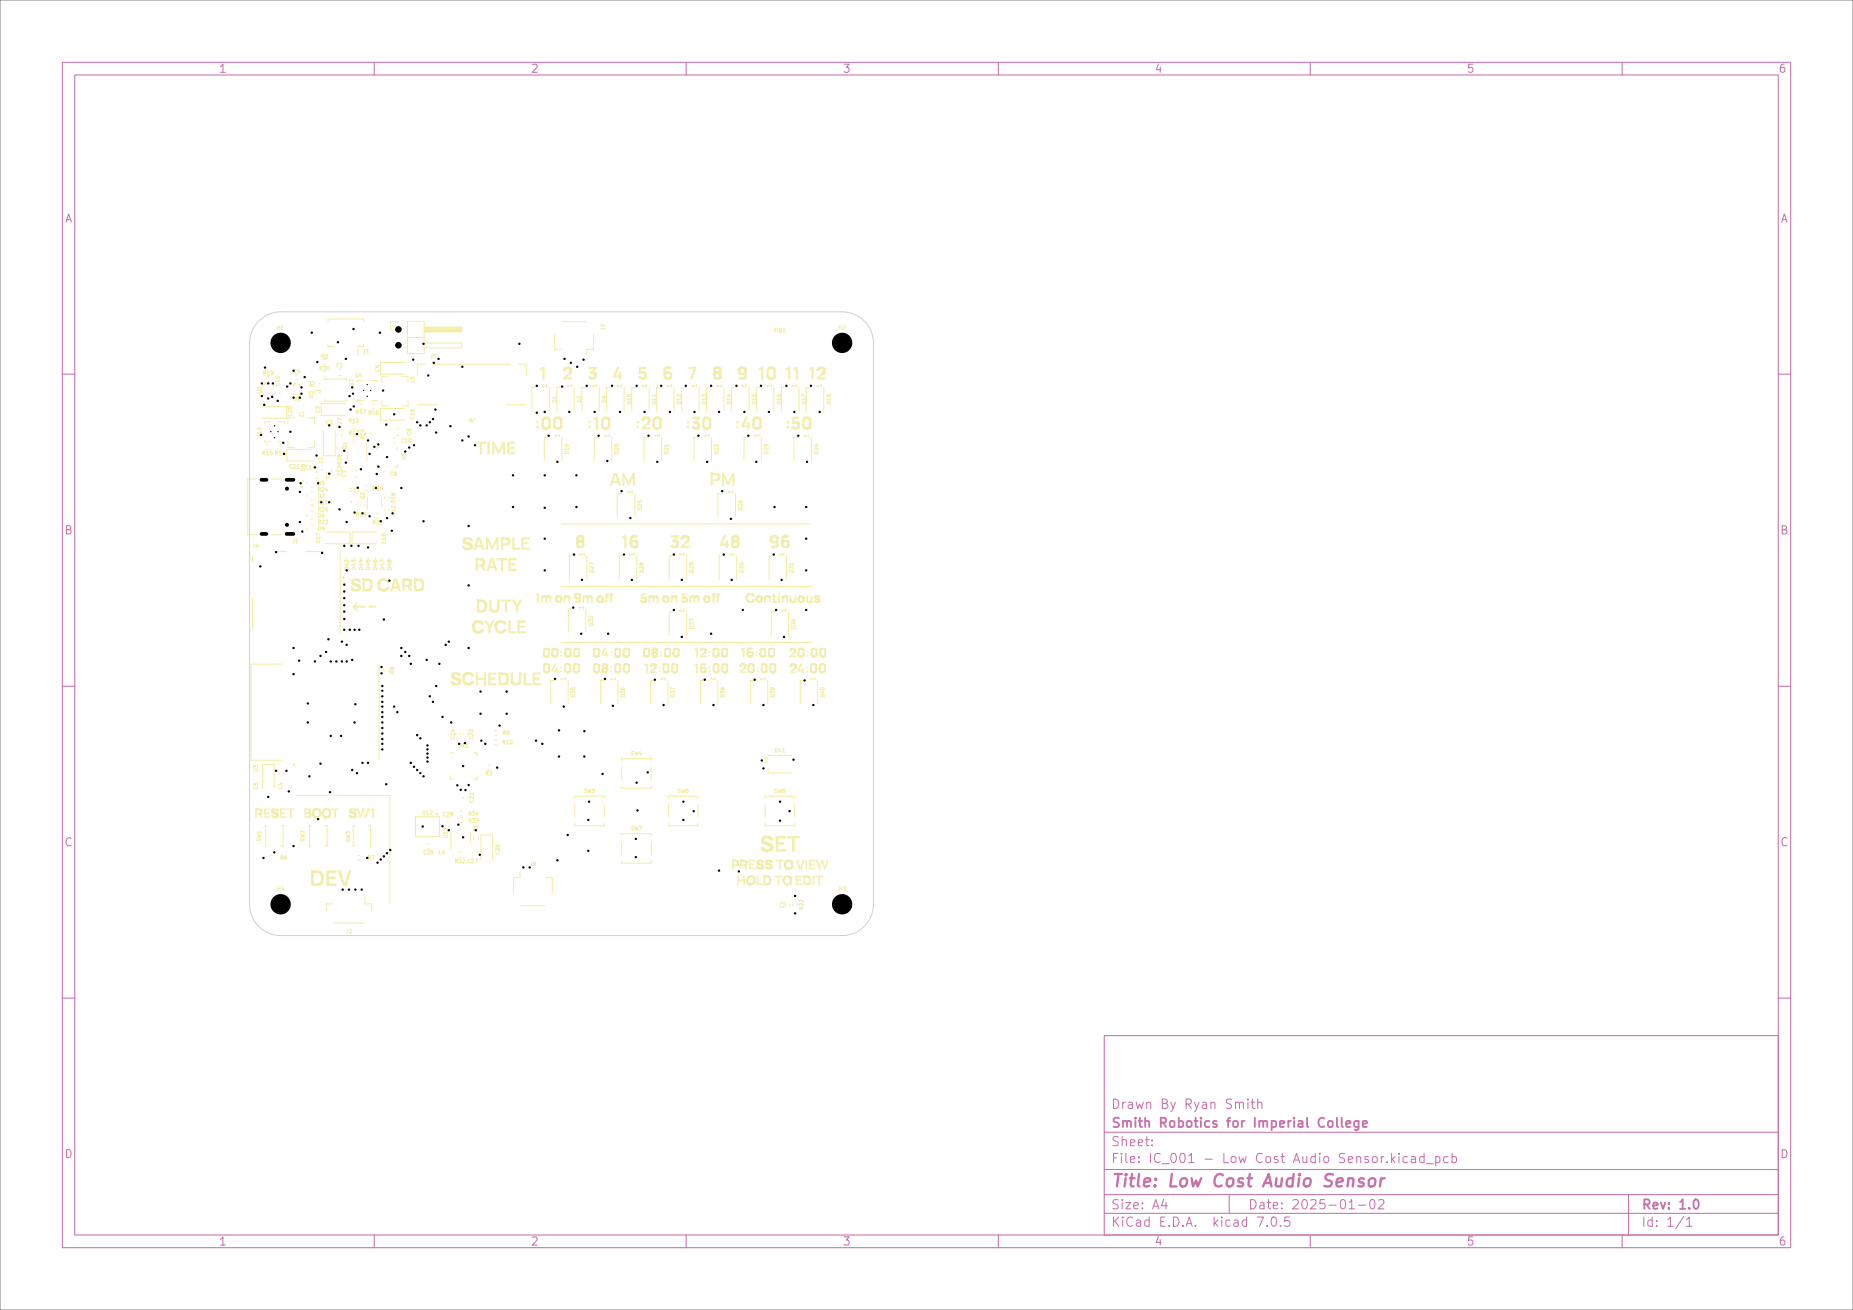
[picture p44: page 5]

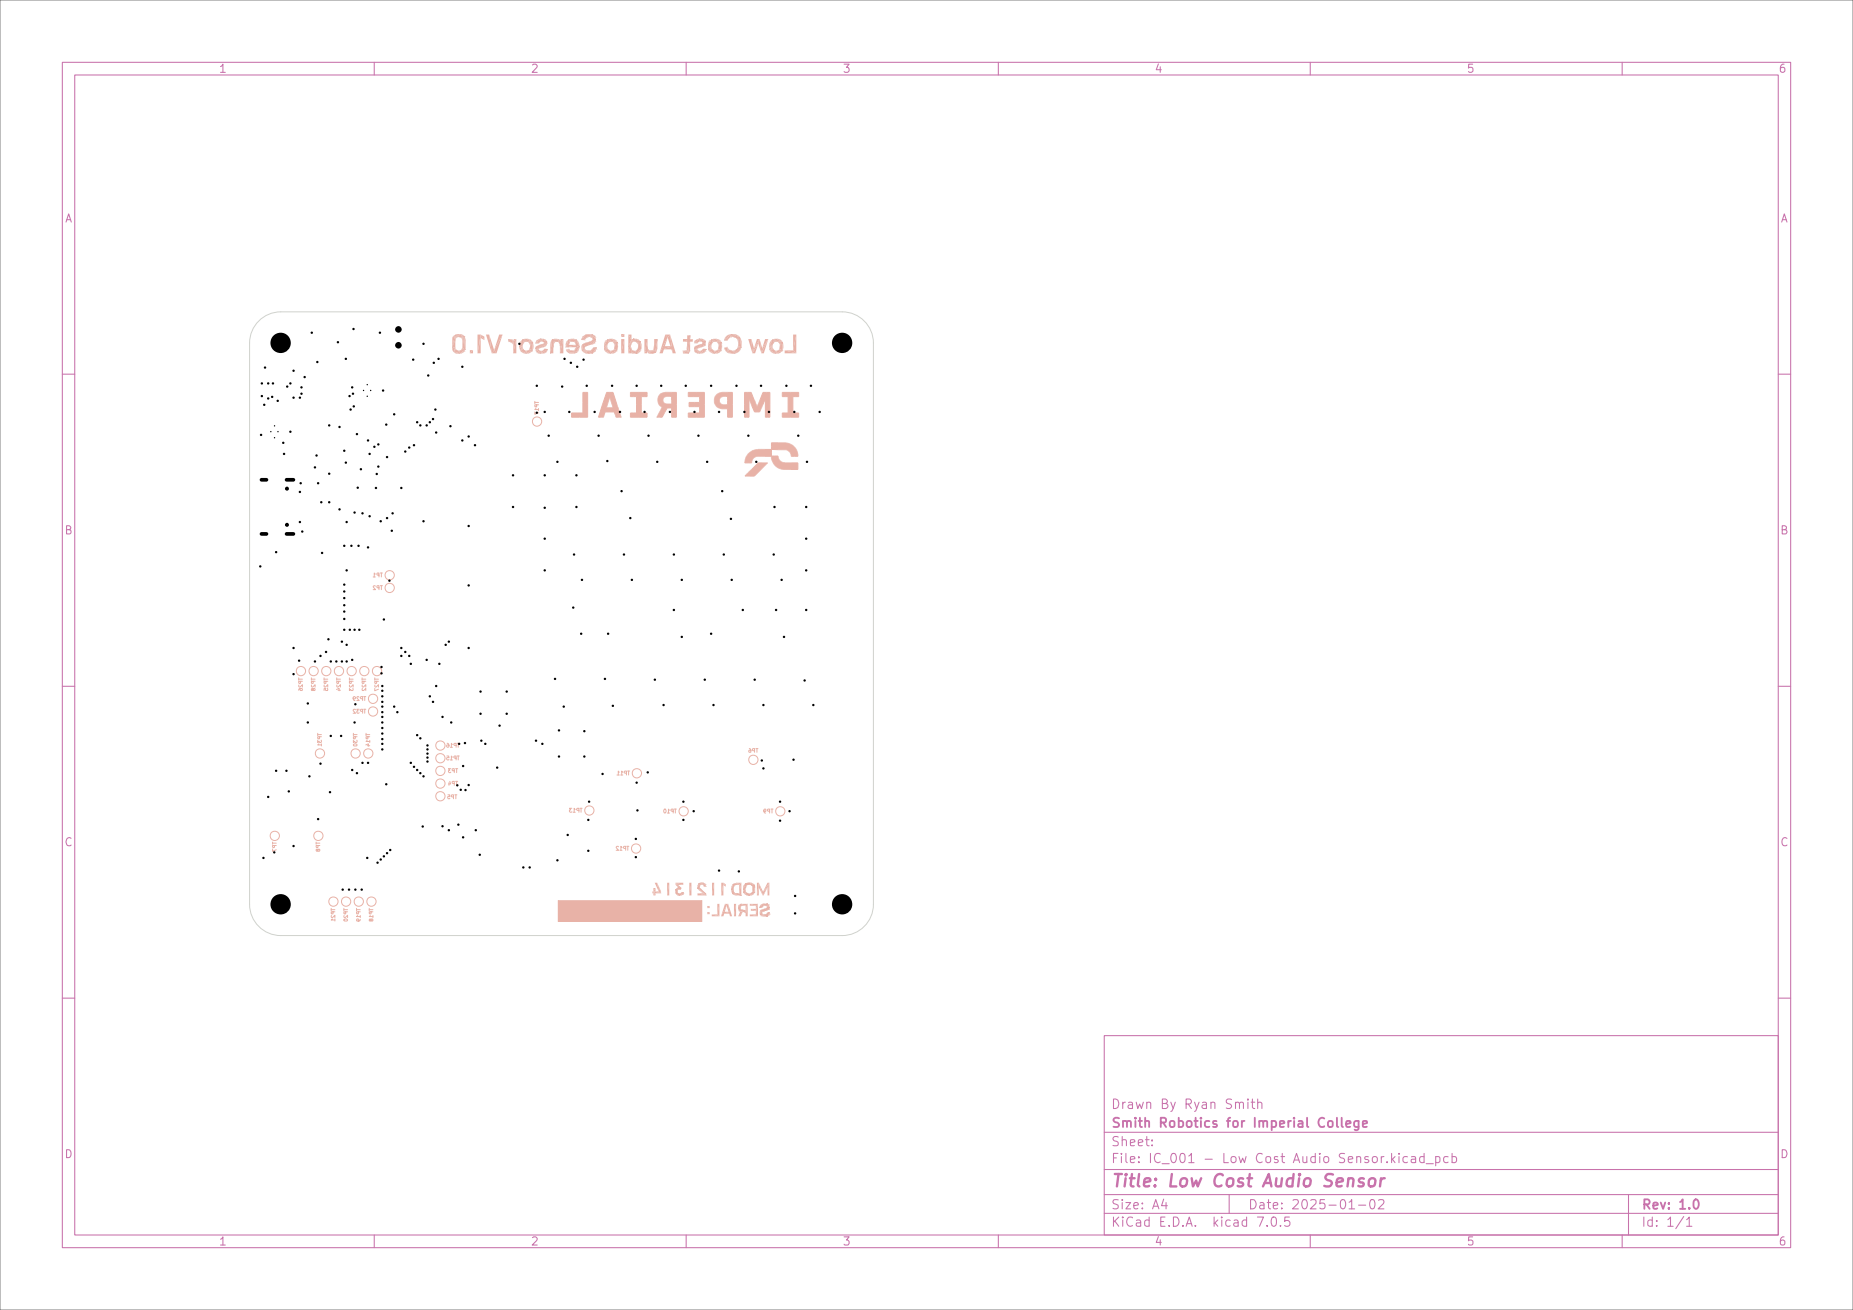
[picture p45: page 6]

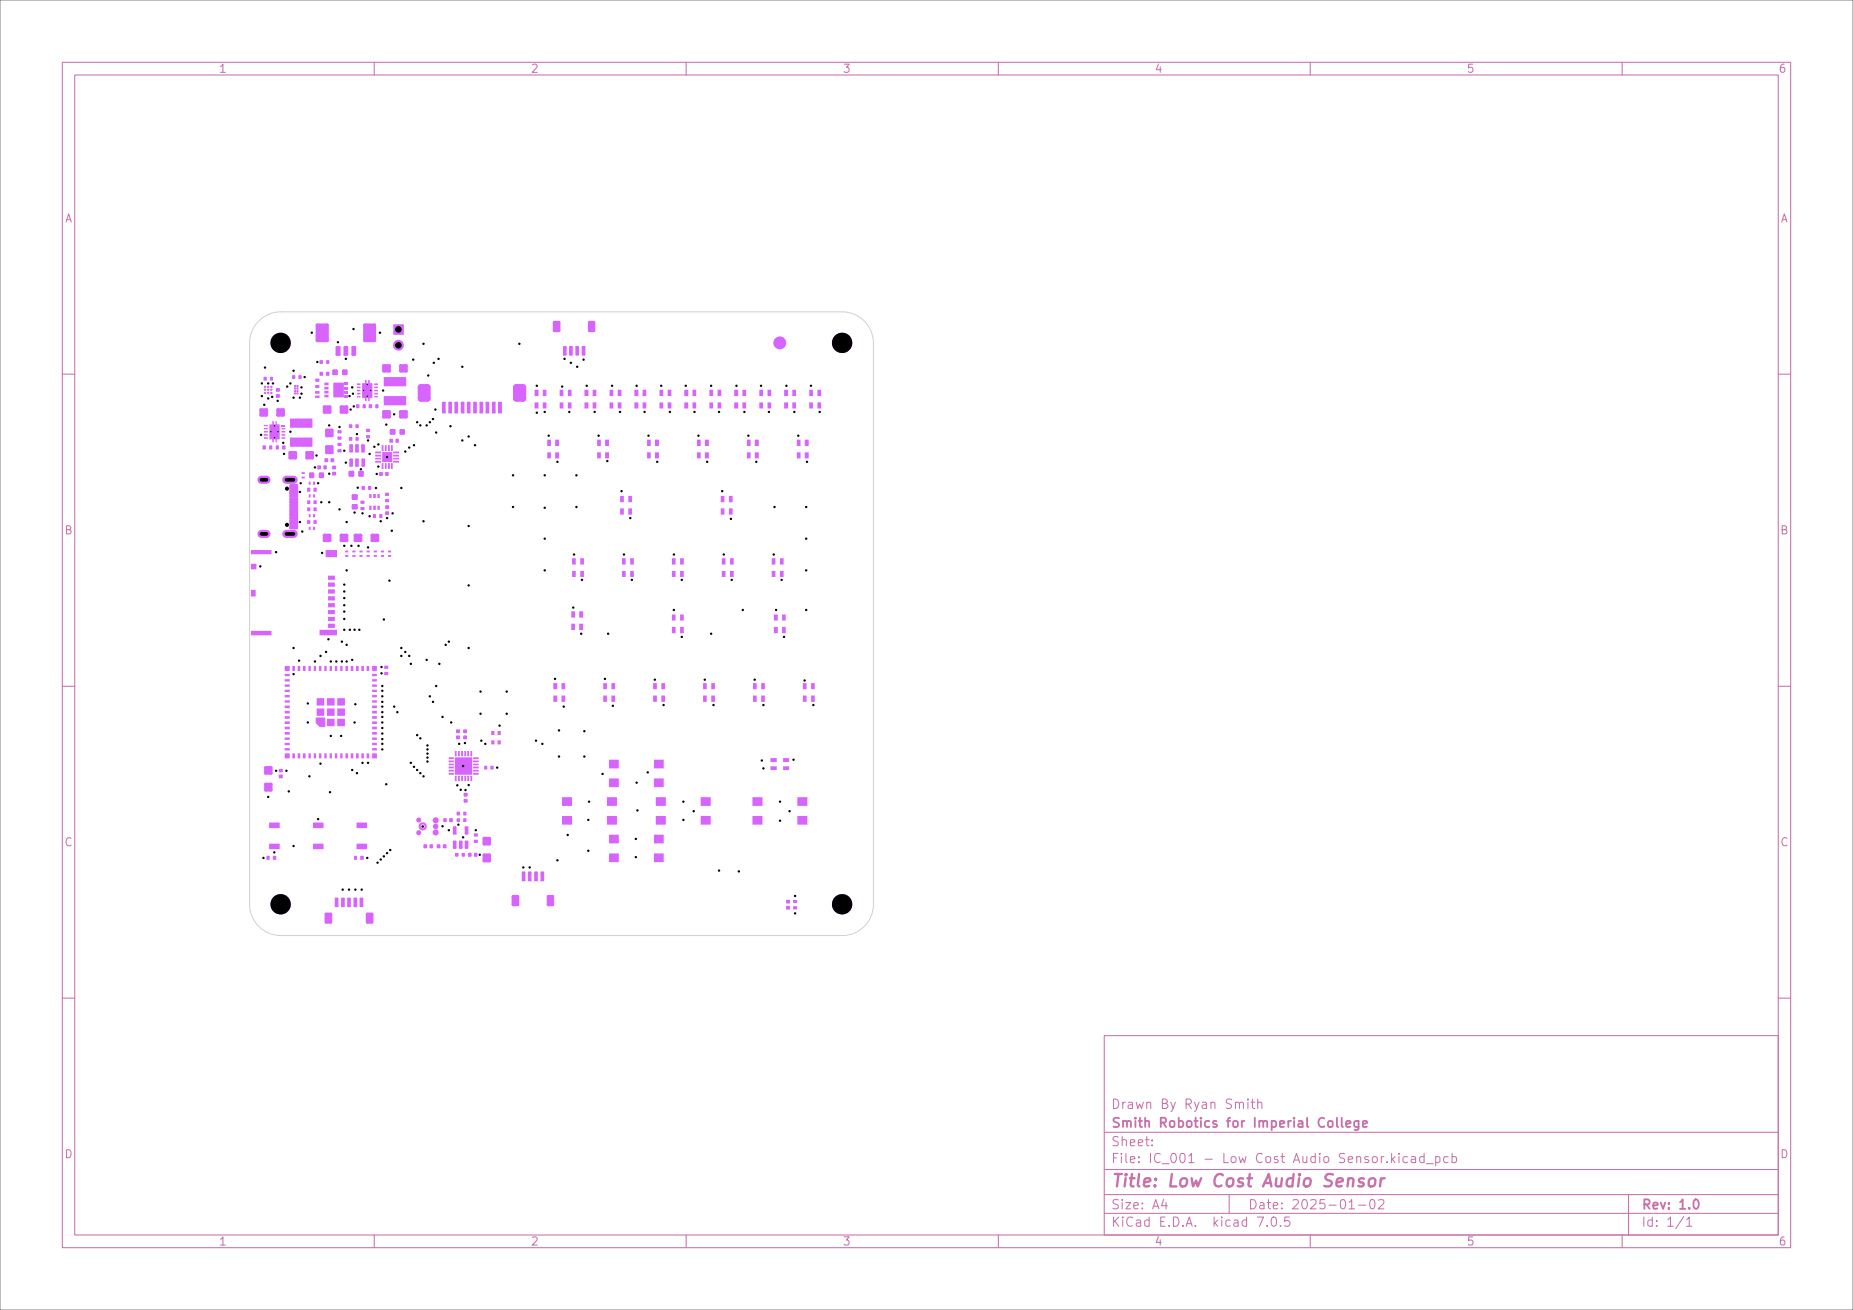
[picture p46: page 7]

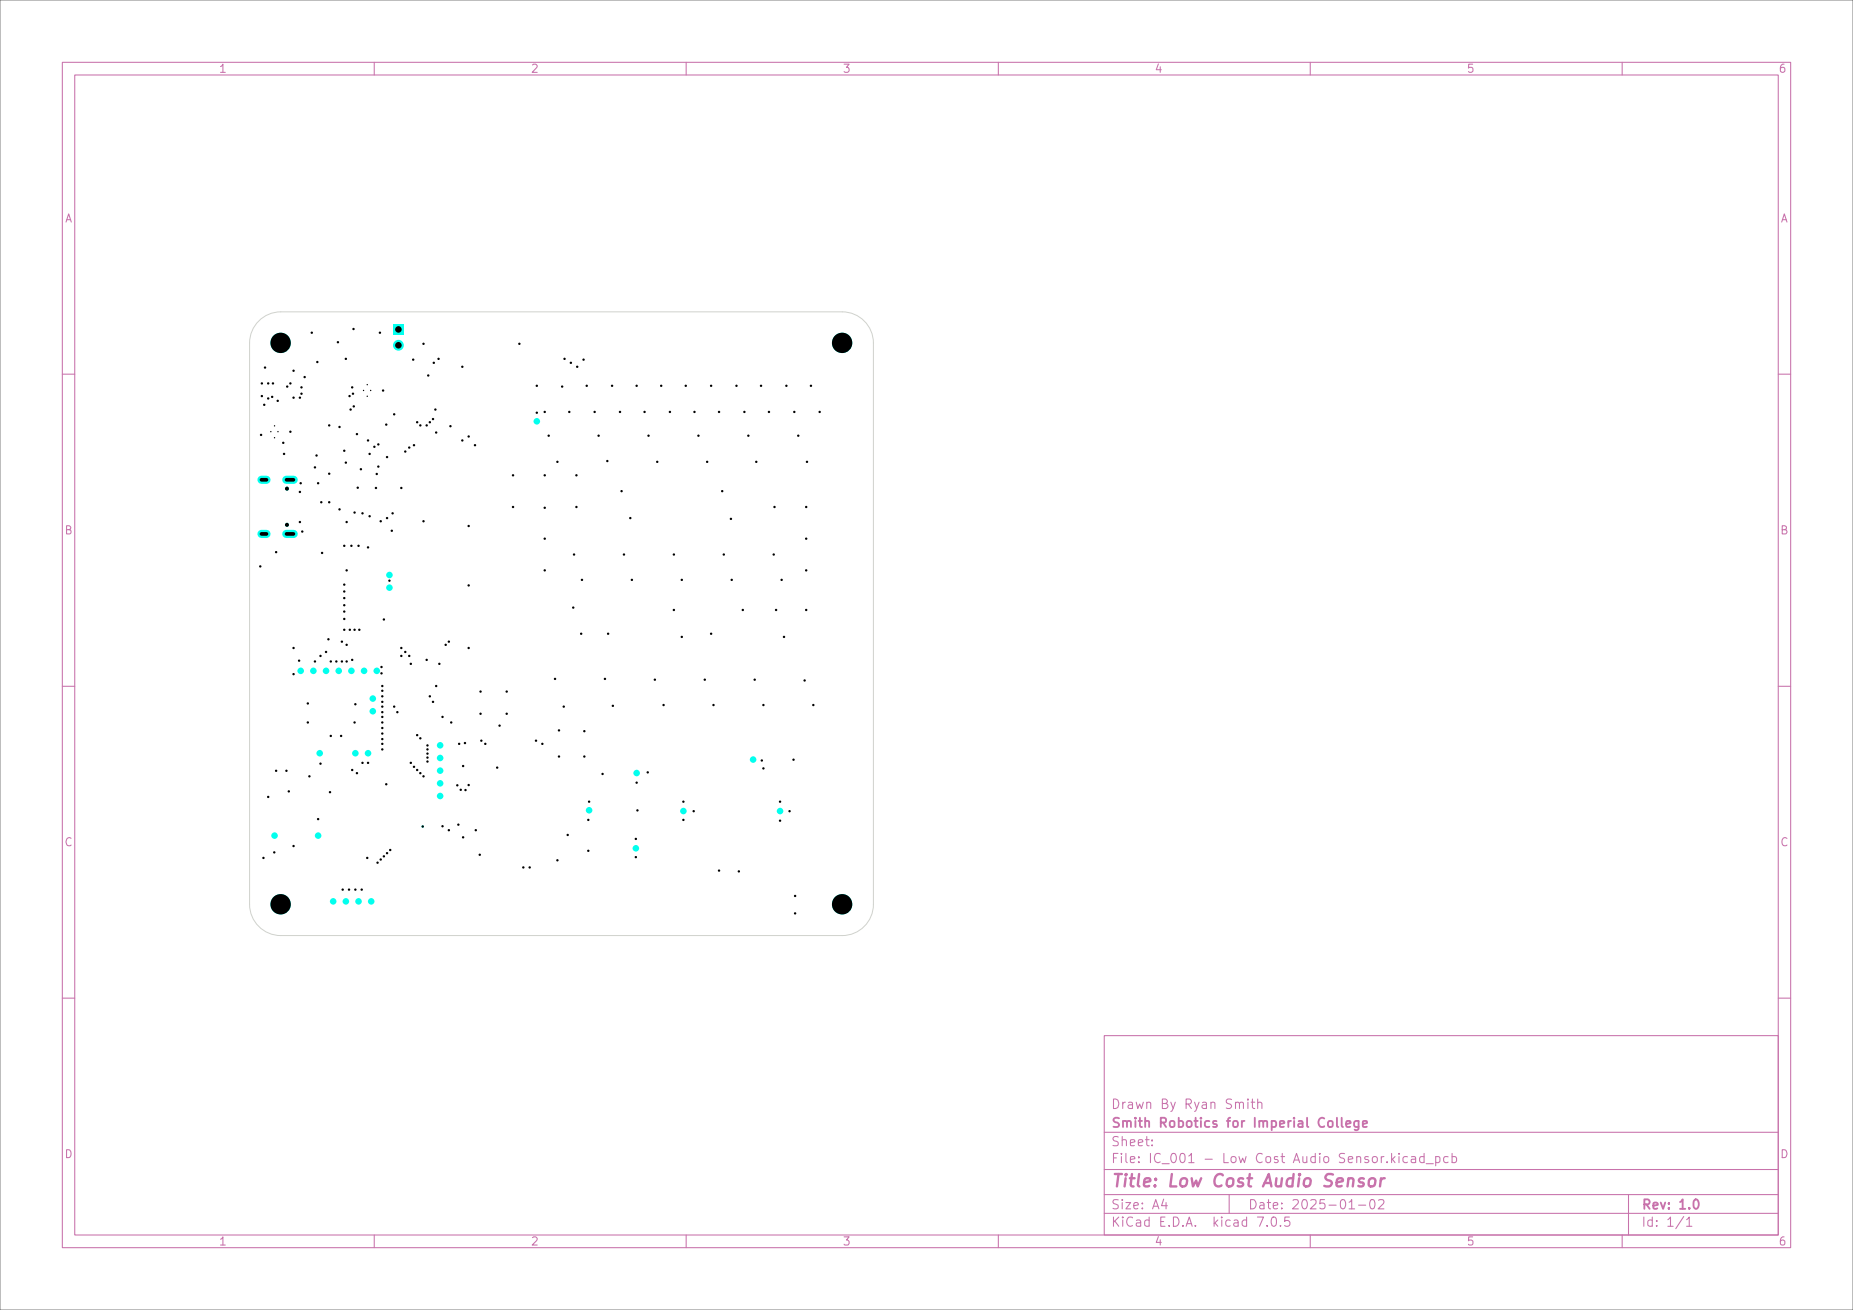
[picture p47: page 8]

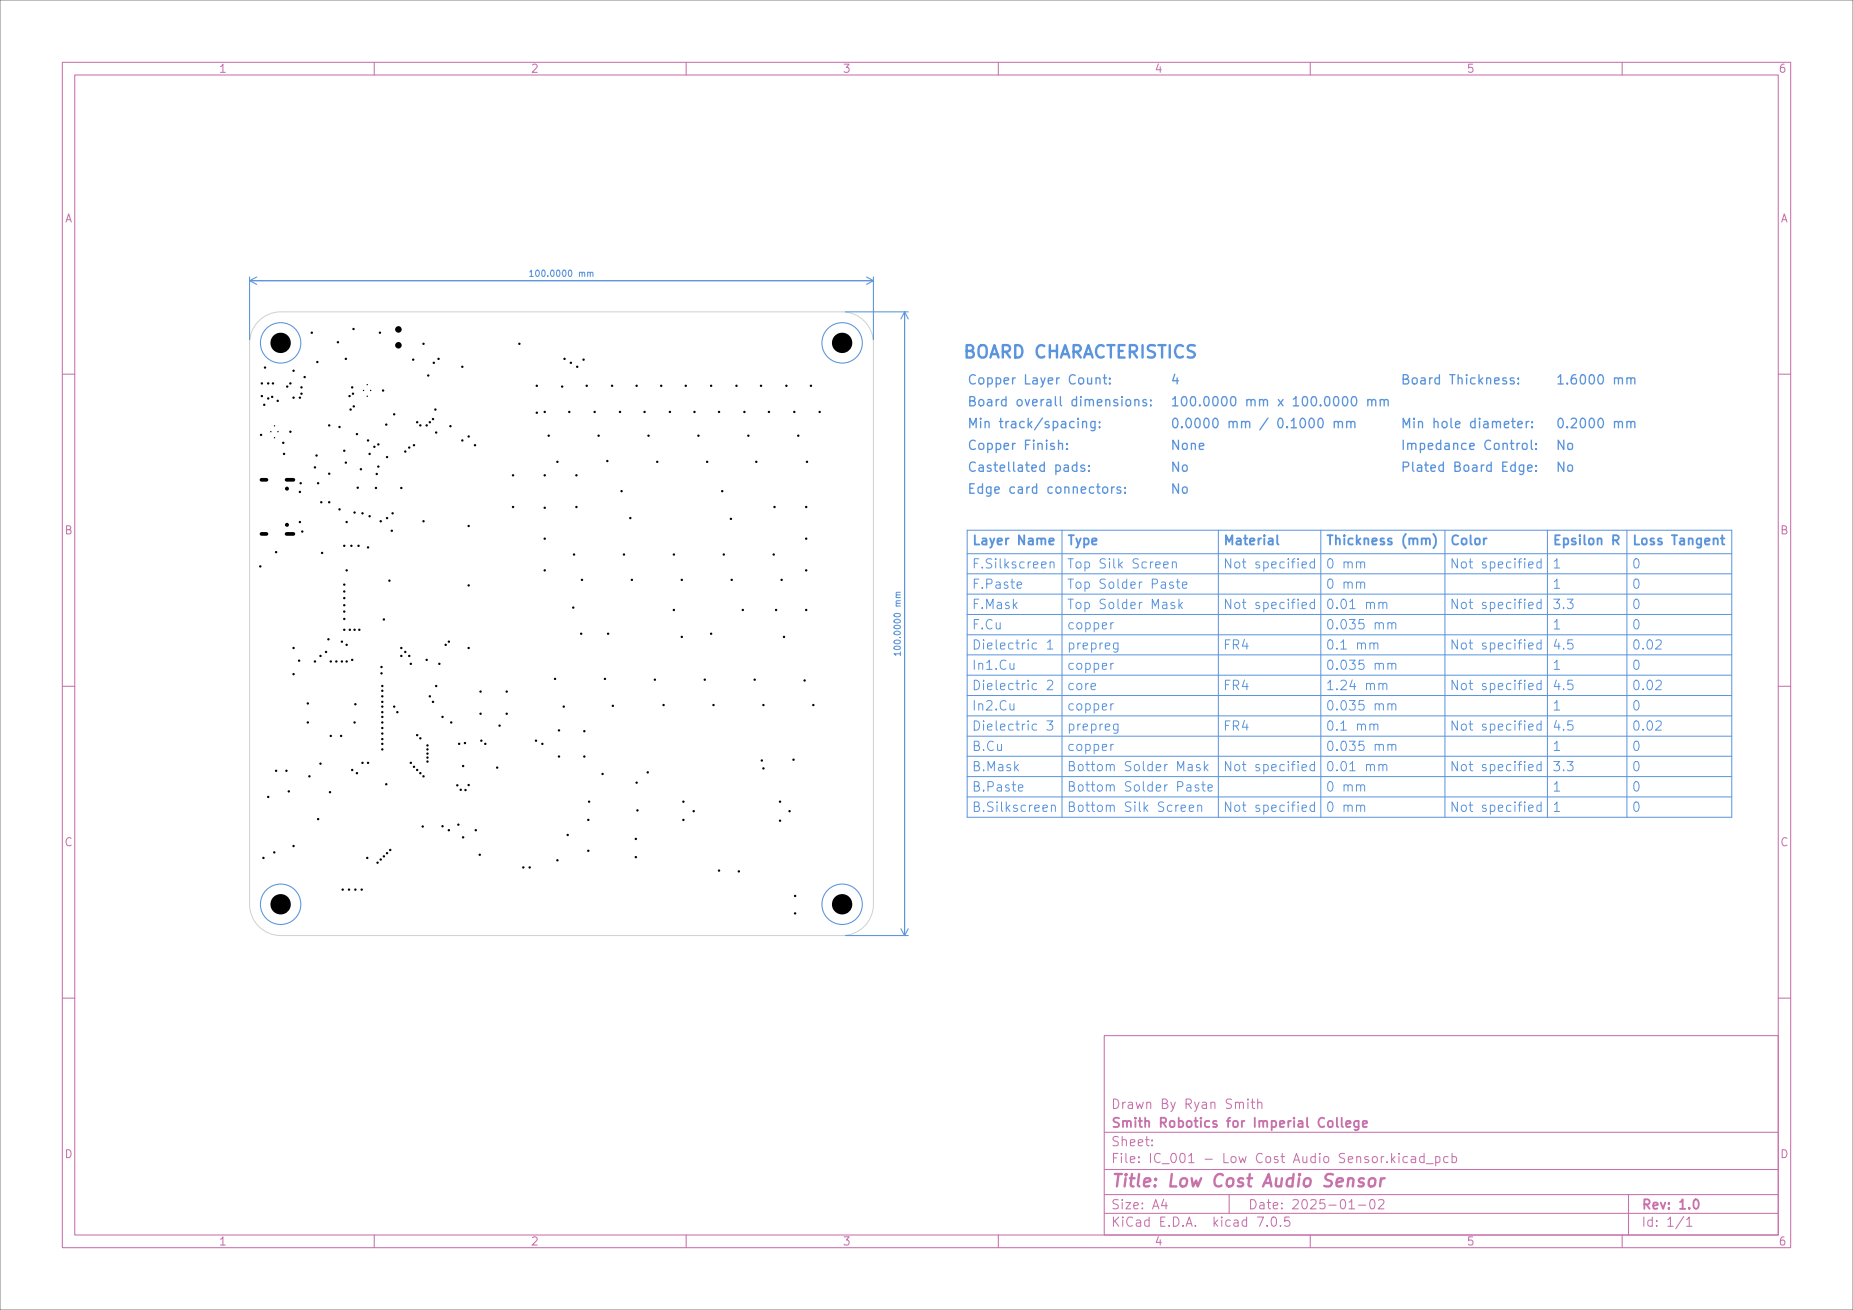
[picture p48: page 9]
