ryanstevensmith/locust_hardware/IC_001 - Low Cost Audio Sensor/working/IC_001 - Low Cost Audio Sensor.kicad_pcb

## KiCad design IC_001 - Low Cost Audio Sensor/working/IC_001 - Low Cost Audio Sensor.kicad_pcb (2026-10-24)

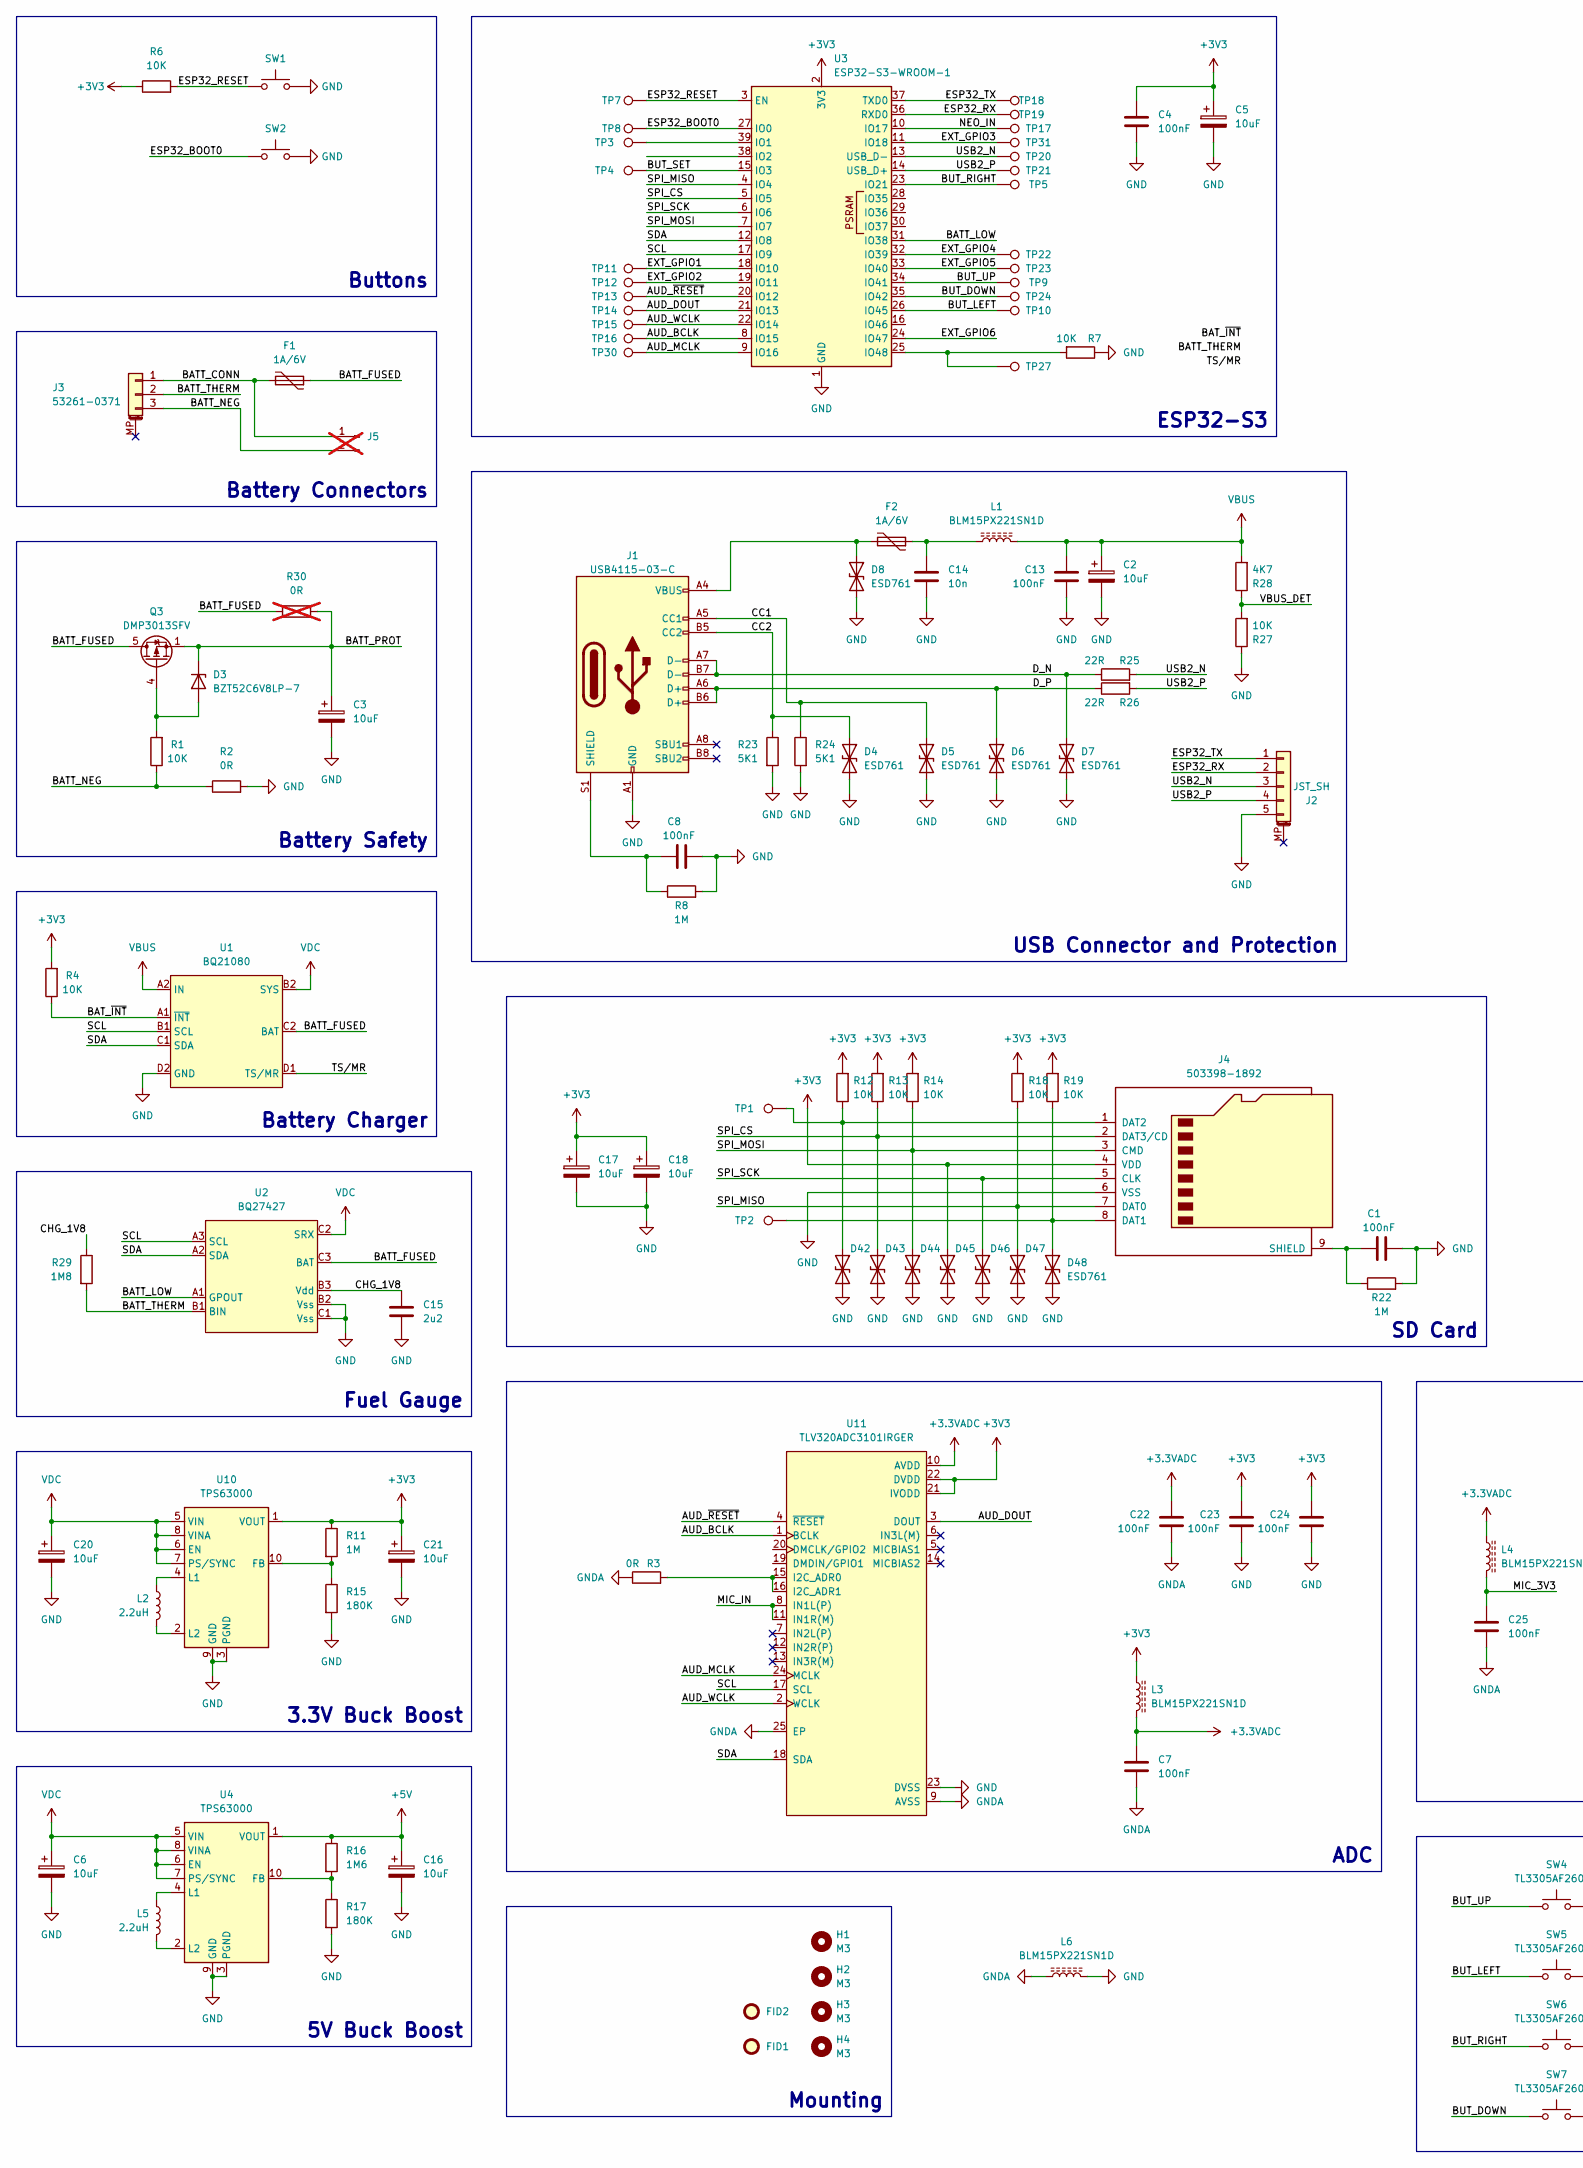
[picture p49: schematic IC_001 - Low Cost Audio Sensor.kicad_sch, Low Cost Audio Sensor, part in row 1, column 1]

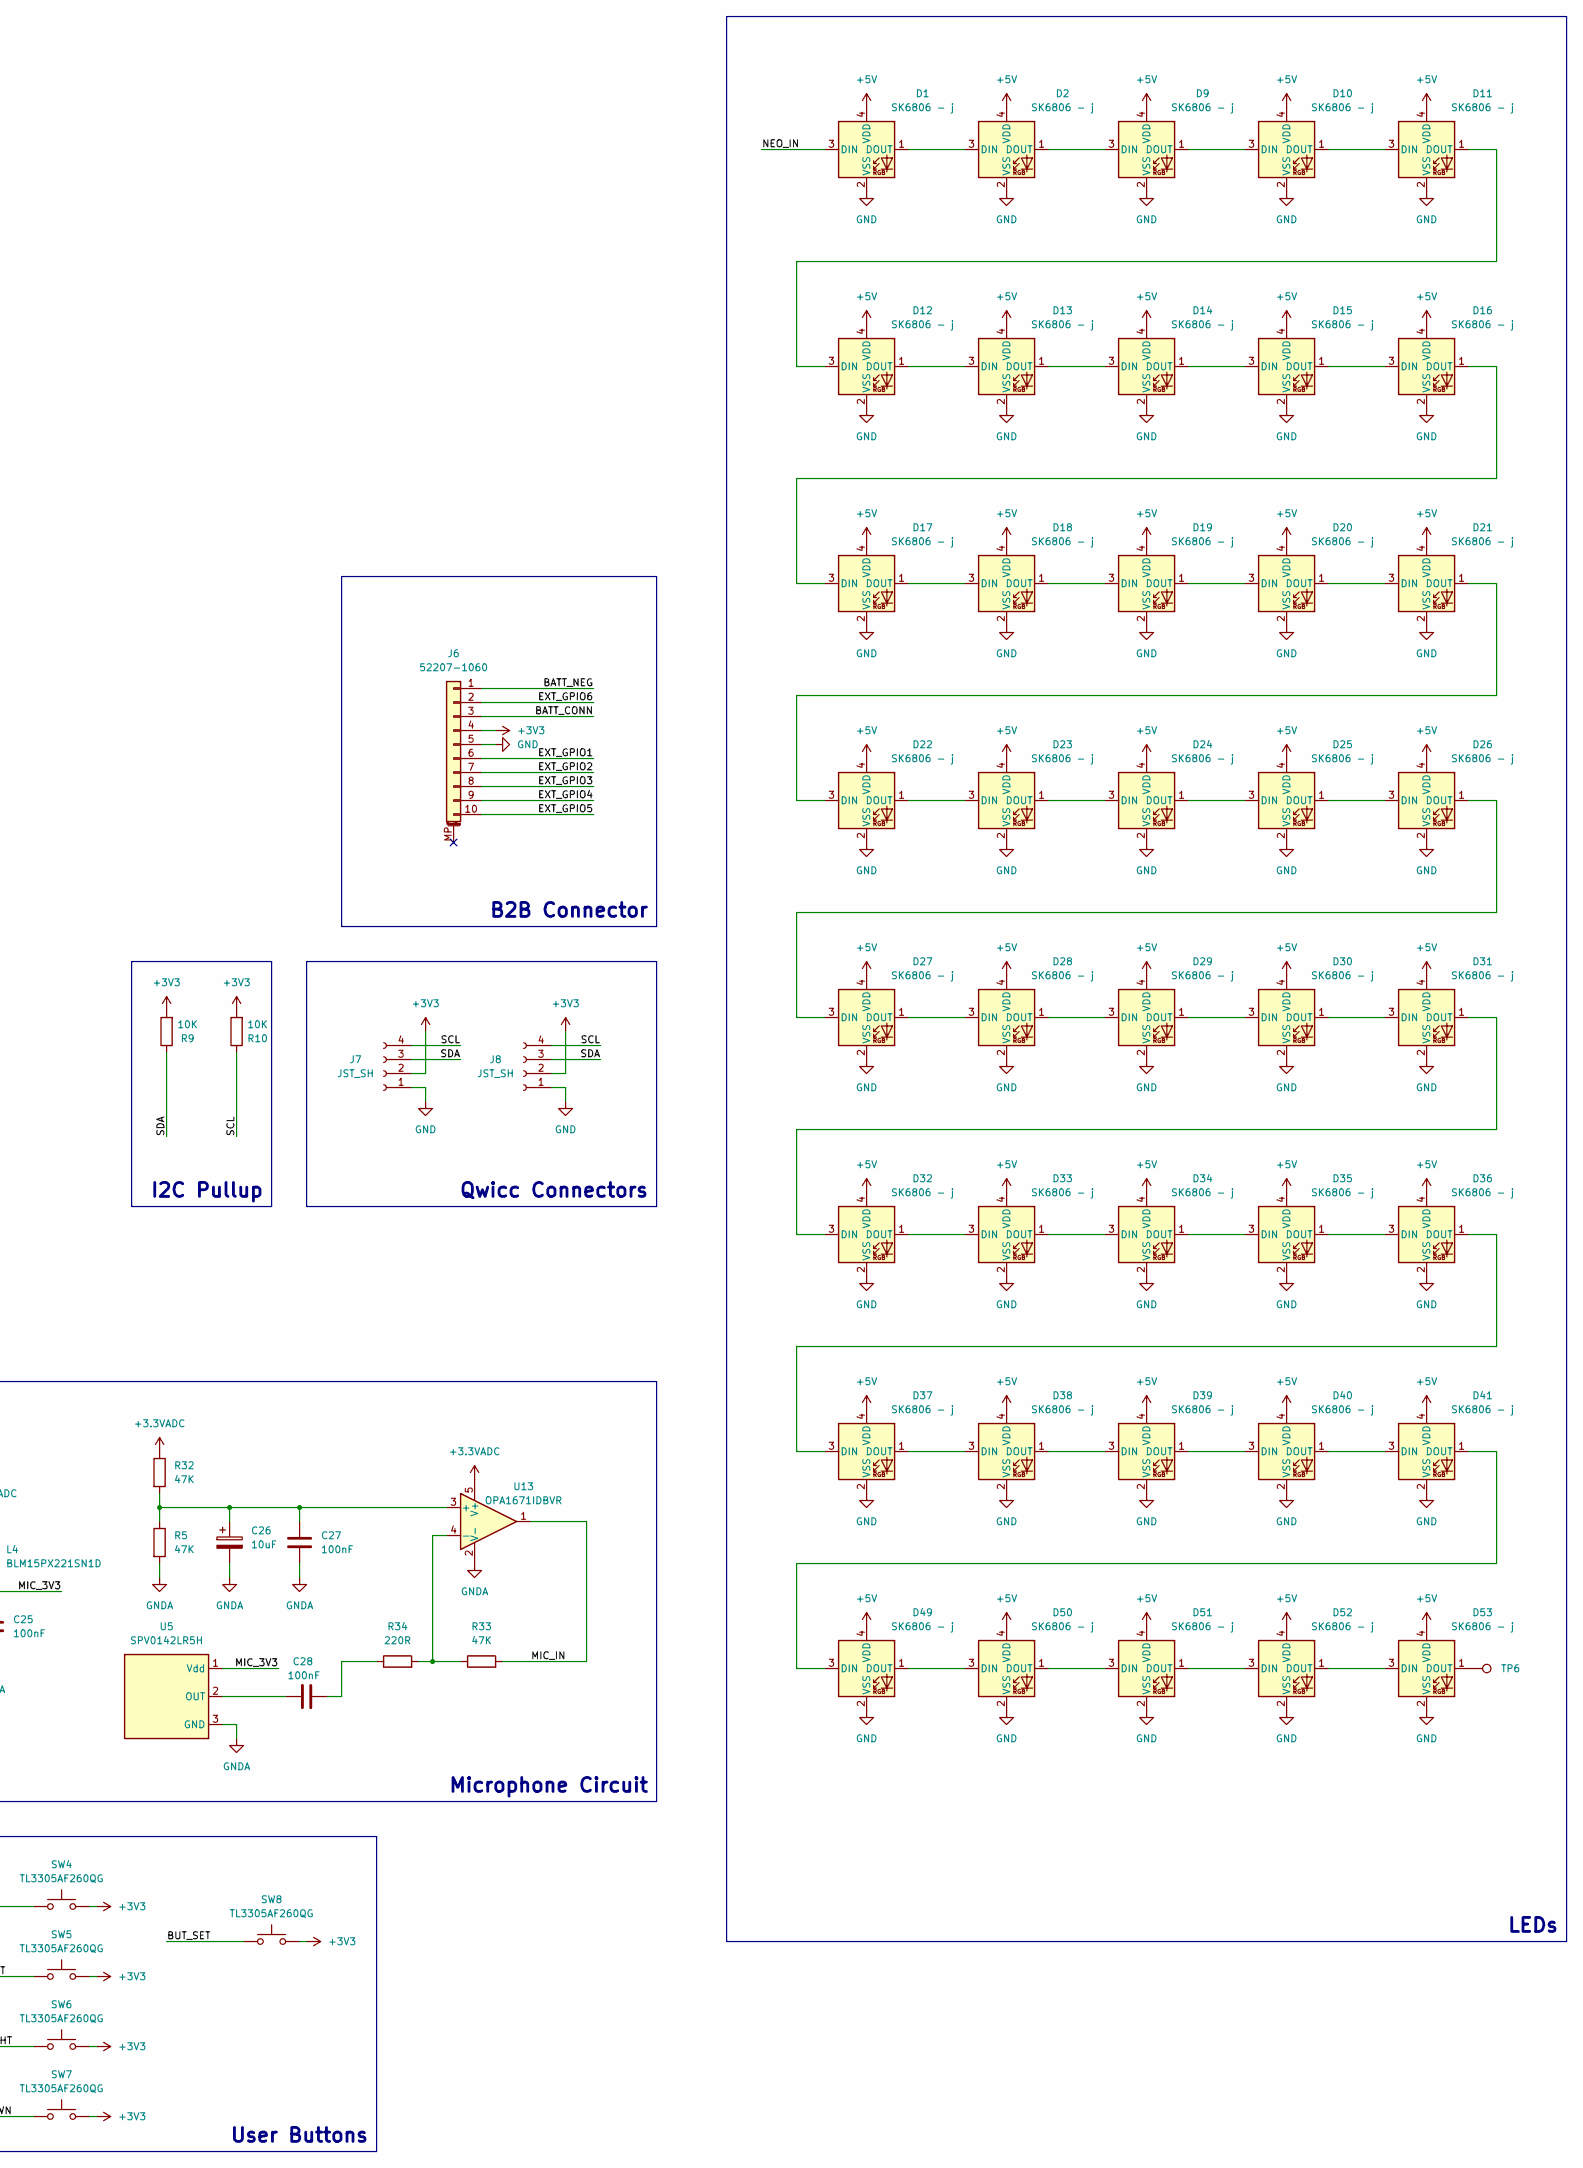
[picture p50: schematic IC_001 - Low Cost Audio Sensor.kicad_sch, Low Cost Audio Sensor, part in row 1, column 2]

Parts:
C1, C4, C7, C8, C13, C22, C23, C24, C25, C27, C28: 100nF; C_0402_1005Metric; Digi-Key 490-6328-2-ND
C2, C3, C5, C6, C16, C17, C18, C20, C21, C26: 10uF; CP_EIA-3216-18_Kemet-A; LCSC C128254
C14: 10n; C_0402_1005Metric; LCSC C1524
C15: 2u2; C_0402_1005Metric; LCSC C193620
D1, D2, D9, D10, D11, D12, D13, D14, D15, D16, D17, D18, D19, D20, D21, D22, D23, D24, D25, D26, D27, D28, D29, D30, D31, D32, D33, D34, D35, D36, D37, D38, D39, D40, D41, D49, D50, D51, D52, D53: SK6806 - j; LED_SK6805_PLCC4_2.4x2.7mm_P1.3mm; LCSC C2909056
D3: BZT52C6V8LP-7; X1-DFN1006-2; LCSC C460796
D4, D5, D6, D7, D8, D42, D43, D44, D45, D46, D47, D48: ESD761; Texas_DPY0002A_0.6x1mm_P0.65mm; LCSC C20345399
F1, F2: 1A/6V; Fuse_0603_1608Metric; LCSC C516069
FID1, FID2: Fiducial; Fiducial_1mm_Mask2mm
H1, H2, H3, H4: M3; MountingHole_3.2mm_M3
J1: USB4115-03-C; USB_C_Receptacle_GCT_USB4115-03-C; LCSC C5250720
J2: JST_SH; JST_SH_BM05B-SRSS-TB_1x05-1MP_P1.00mm_Vertical; LCSC C160391
J3: 53261-0371; Molex_PicoBlade_53261-0371_1x03-1MP_P1.25mm_Horizontal; LCSC C293630
J4: 503398-1892; LCSC C428492
J5: Conn_01x02_Pin; PinHeader_1x02_P2.54mm_Horizontal; not fitted
J6: 52207-1060; LCSC C3168739
J7, J8: JST_SH; JST_SH_SM04B-SRSS-TB_1x04-1MP_P1.00mm_Horizontal; LCSC C160404
L1, L3, L4, L6: BLM15PX221SN1D; L_0402_1005Metric; LCSC C160973
L2, L5: 2.2uH; L_Bourns-SRN4018; LCSC C135262
Q3: DMP3013SFV; Diodes_PowerDI3333-8; LCSC C264098
R1, R4, R6, R7, R9, R10, R12, R13, R14, R18, R19, R27: 10K; R_0402_1005Metric; Digi-Key 541-10.0KLTR-ND
R2, R3: 0R; R_0402_1005Metric; LCSC C17168
R5, R32, R33: 47K; R_0402_1005Metric; LCSC C25792
R8, R11, R22: 1M; R_0402_1005Metric; LCSC C26087
R15, R17: 180K; R_0402_1005Metric; LCSC C25541
R16: 1M6; R_0402_1005Metric; LCSC C57065
R23, R24: 5K1; R_0402_1005Metric; LCSC C25941
R25, R26: 22R; R_0402_1005Metric; LCSC C25152
R28: 4K7; R_0402_1005Metric; LCSC C25900
R29: 1M8; R_0402_1005Metric; LCSC C473021
R30: 0R; R_0402_1005Metric; LCSC C17168; not fitted
R34: 220R; R_0402_1005Metric; LCSC C25151
SW1, SW2: SW_Push; SW_SPST_B3U-1000P; LCSC C231329
SW4, SW5, SW6, SW7, SW8: TL3305AF260QG; SW_SPST_TL3305A; LCSC C2886902
TP1, TP2, TP3, TP4, TP5, TP6, TP7, TP8, TP9, TP10, TP11, TP12, TP13, TP14, TP15, TP16, TP17, TP18, TP19, TP20, TP21, TP22, TP23, TP24, TP27, TP30, TP31: TestPoint; TestPoint_Pad_D1.0mm
U1: BQ21080; Texas_DSBGA-8-1.6mmx1mm_P0.4mm; LCSC C6869615
U2: BQ27427; Texas_DSBGA-9-1.6mmx1.6_P0.5mm; LCSC C6075475
U3: ESP32-S3-WROOM-1; LCSC C2913202
U4, U10: TPS63000; Texas_DRC0010J_ThermalVias; LCSC C24966
U5: SPV0142LR5H; SPV0142LR5H-1; LCSC C45062176
U11: TLV320ADC3101IRGER; QFN-24-1EP_4x4mm_P0.5mm_EP2.8x2.8mm; LCSC C162409
U13: OPA1671IDBVR; TSOT-23-5; LCSC C1849409

Connections:
+3.3VADC: C7.1, C22.1, L3.2, L4.1, R32.1, U11.10 (AVDD), U13.5 (V+)
+3V3: C4.1, C5.1, C17.1, C18.1, C21.1, C23.1, C24.1, D45.1 (A1), J4.4 (VDD), J6.4, J7.2, J8.2, L3.1, R4.2, R6.1, R9.2, R10.2, R11.1, R12.2, R13.2, R14.2, R18.2, R19.2, SW4.2, SW5.2, SW6.2, SW7.2, SW8.2, U3.2 (3V3), U10.1 (VOUT), U11.21 (IVODD), U11.22 (DVDD)
+5V: C16.1, D1.4 (VDD), D2.4 (VDD), D9.4 (VDD), D10.4 (VDD), D11.4 (VDD), D12.4 (VDD), D13.4 (VDD), D14.4 (VDD), D15.4 (VDD), D16.4 (VDD), D17.4 (VDD), D18.4 (VDD), D19.4 (VDD), D20.4 (VDD), D21.4 (VDD), D22.4 (VDD), D23.4 (VDD), D24.4 (VDD), D25.4 (VDD), D26.4 (VDD), D27.4 (VDD), D28.4 (VDD), D29.4 (VDD), D30.4 (VDD), D31.4 (VDD), D32.4 (VDD), D33.4 (VDD), D34.4 (VDD), D35.4 (VDD), D36.4 (VDD), D37.4 (VDD), D38.4 (VDD), D39.4 (VDD), D40.4 (VDD), D41.4 (VDD), D49.4 (VDD), D50.4 (VDD), D51.4 (VDD), D52.4 (VDD), D53.4 (VDD), R16.1, U4.1 (VOUT)
/AUD_BCLK: TP16.1, U3.8 (IO15), U11.1 (BCLK)
/AUD_DOUT: TP14.1, U3.21 (IO13), U11.3 (DOUT)
/AUD_MCLK: TP30.1, U3.9 (IO16), U11.24 (MCLK)
/AUD_WCLK: TP15.1, U3.22 (IO14), U11.2 (WCLK)
/AUD_~RESET: TP13.1, U3.20 (IO12), U11.4 (~RESET)
/BATT_CONN: F1.2, J3.1, J5.1, J6.3
/BATT_FUSED: F1.1, Q3.5 (D), R30.1, U1.C2 (BAT), U2.C3 (BAT)
/BATT_LOW: U2.A1 (GPOUT), U3.31 (IO38)
/BATT_NEG: J3.3, J5.2, J6.1, R1.1, R2.1
/BATT_PROT: C3.1, D3.1 (K), Q3.1 (S), Q3.2 (S), Q3.3 (S), R30.2
/BATT_THERM: J3.2, R29.2, U2.B1 (BIN)
/BAT_~INT: R4.1, U1.A1 (~INT)
/BUT_DOWN: SW7.1, TP24.1, U3.35 (IO42)
/BUT_LEFT: SW5.1, TP10.1, U3.26 (IO45)
/BUT_RIGHT: SW6.1, TP5.1, U3.23 (IO21)
/BUT_SET: SW8.1, TP4.1, U3.15 (IO3)
/BUT_UP: SW4.1, TP9.1, U3.34 (IO41)
/CC1: D5.1 (A1), J1.A5 (CC1), R24.1
/CC2: D4.1 (A1), J1.B5 (CC2), R23.1
/CHG_1V8: C15.1, R29.1, U2.B3 (Vdd)
/D_N: D7.1 (A1), J1.A7 (D-), J1.B7 (D-), R25.1
/D_P: D6.1 (A1), J1.A6 (D+), J1.B6 (D+), R26.1
/ESP32_BOOT0: SW2.1, TP8.1, U3.27 (IO0)
/ESP32_RESET: R6.2, SW1.1, TP7.1, U3.3 (EN)
/ESP32_RX: J2.2, TP19.1, U3.36 (RXD0)
/ESP32_TX: J2.1, TP18.1, U3.37 (TXD0)
/EXT_GPIO1: J6.6, TP11.1, U3.18 (IO10)
/EXT_GPIO2: J6.7, TP12.1, U3.19 (IO11)
/EXT_GPIO3: J6.8, TP31.1, U3.11 (IO18)
/EXT_GPIO4: J6.9, TP22.1, U3.32 (IO39)
/EXT_GPIO5: J6.10, TP23.1, U3.33 (IO40)
/EXT_GPIO6: J6.2, U3.24 (IO47)
/MIC_3V3: C25.1, L4.2, U5.1 (Vdd)
/MIC_IN: R33.2, U11.8 (IN1L(P)), U11.11 (IN1R(M)), U13.1
/NEO_IN: D1.3 (DIN), TP17.1, U3.10 (IO17)
/SCL: J7.4, J8.4, R10.1, U1.B1 (SCL), U2.A3 (SCL), U3.17 (IO9), U11.17 (SCL)
/SDA: J7.3, J8.3, R9.1, U1.C1 (SDA), U2.A2 (SDA), U3.12 (IO8), U11.18 (SDA)
/SPI_CS: D43.1 (A1), J4.2 (DAT3/CD), R13.1, U3.5 (IO5)
/SPI_MISO: D47.1 (A1), J4.7 (DAT0), R18.1, U3.4 (IO4)
/SPI_MOSI: D44.1 (A1), J4.3 (CMD), R14.1, U3.7 (IO7)
/SPI_SCK: D46.1 (A1), J4.5 (CLK), U3.6 (IO6)
/TS/MR: U1.D1 (TS/MR)
/USB2_N: J2.3, R25.2, TP20.1, U3.13 (USB_D-)
/USB2_P: J2.4, R26.2, TP21.1, U3.14 (USB_D+)
/VBUS_DET: R27.2, R28.1
GND: C1.1, C2.2, C3.2, C4.2, C5.2, C6.2, C8.1, C13.2, C14.2, C15.2, C16.2, C17.2, C18.2, C20.2, C21.2, C23.2, C24.2, D1.2 (VSS), D2.2 (VSS), D4.2 (A2), D5.2 (A2), D6.2 (A2), D7.2 (A2), D8.2 (A2), D9.2 (VSS), D10.2 (VSS), D11.2 (VSS), D12.2 (VSS), D13.2 (VSS), D14.2 (VSS), D15.2 (VSS), D16.2 (VSS), D17.2 (VSS), D18.2 (VSS), D19.2 (VSS), D20.2 (VSS), D21.2 (VSS), D22.2 (VSS), D23.2 (VSS), D24.2 (VSS), D25.2 (VSS), D26.2 (VSS), D27.2 (VSS), D28.2 (VSS), D29.2 (VSS), D30.2 (VSS), D31.2 (VSS), D32.2 (VSS), D33.2 (VSS), D34.2 (VSS), D35.2 (VSS), D36.2 (VSS), D37.2 (VSS), D38.2 (VSS), D39.2 (VSS), D40.2 (VSS), D41.2 (VSS), D42.2 (A2), D43.2 (A2), D44.2 (A2), D45.2 (A2), D46.2 (A2), D47.2 (A2), D48.2 (A2), D49.2 (VSS), D50.2 (VSS), D51.2 (VSS), D52.2 (VSS), D53.2 (VSS), J1.A1 (GND), J1.A12 (GND), J1.B1 (GND), J1.B12 (GND), J2.5, J4.6 (VSS), J6.5, J7.1, J8.1, L6.2, R2.2, R7.1, R8.2, R15.2, R17.2, R22.2, R23.2, R24.2, R27.1, SW1.2, SW2.2, U1.D2 (GND), U2.B2 (Vss), U2.C1 (Vss), U3.1 (GND), U3.40 (GND), U3.41 (GND), U4.3 (PGND), U4.9 (GND), U4.11 (PGND), U10.3 (PGND), U10.9 (GND), U10.11 (PGND), U11.23 (DVSS)
GNDA: C7.2, C22.2, C25.2, C26.2, C27.2, L6.1, R3.1, R5.2, U5.3 (GND), U11.9 (AVSS), U11.25 (EP), U13.2 (V-)
unnamed: C14.1, F2.1, L1.1
unnamed: C28.2, R34.1
unnamed: D1.1 (DOUT), D2.3 (DIN)
unnamed: D2.1 (DOUT), D9.3 (DIN)
unnamed: D3.2 (A), Q3.4 (G), R1.2
unnamed: D8.1 (A1), F2.2, J1.A4 (VBUS), J1.A9 (VBUS), J1.B4 (VBUS), J1.B9 (VBUS)
unnamed: D9.1 (DOUT), D10.3 (DIN)
unnamed: D10.1 (DOUT), D11.3 (DIN)
unnamed: D11.1 (DOUT), D12.3 (DIN)
unnamed: D12.1 (DOUT), D13.3 (DIN)
unnamed: D13.1 (DOUT), D14.3 (DIN)
unnamed: D14.1 (DOUT), D15.3 (DIN)
unnamed: D15.1 (DOUT), D16.3 (DIN)
unnamed: D16.1 (DOUT), D17.3 (DIN)
unnamed: D17.1 (DOUT), D18.3 (DIN)
unnamed: D18.1 (DOUT), D19.3 (DIN)
unnamed: D19.1 (DOUT), D20.3 (DIN)
unnamed: D20.1 (DOUT), D21.3 (DIN)
unnamed: D21.1 (DOUT), D22.3 (DIN)
unnamed: D22.1 (DOUT), D23.3 (DIN)
unnamed: D23.1 (DOUT), D24.3 (DIN)
unnamed: D24.1 (DOUT), D25.3 (DIN)
unnamed: D25.1 (DOUT), D26.3 (DIN)
unnamed: D26.1 (DOUT), D27.3 (DIN)
unnamed: D27.1 (DOUT), D28.3 (DIN)
unnamed: D28.1 (DOUT), D29.3 (DIN)
unnamed: D29.1 (DOUT), D30.3 (DIN)
unnamed: D30.1 (DOUT), D31.3 (DIN)
unnamed: D31.1 (DOUT), D32.3 (DIN)
unnamed: D32.1 (DOUT), D33.3 (DIN)
unnamed: D33.1 (DOUT), D34.3 (DIN)
unnamed: D34.1 (DOUT), D35.3 (DIN)
unnamed: D35.1 (DOUT), D36.3 (DIN)
unnamed: D36.1 (DOUT), D37.3 (DIN)
unnamed: D37.1 (DOUT), D38.3 (DIN)
unnamed: D38.1 (DOUT), D39.3 (DIN)
unnamed: D39.1 (DOUT), D40.3 (DIN)
unnamed: D40.1 (DOUT), D41.3 (DIN)
unnamed: D41.1 (DOUT), D49.3 (DIN)
unnamed: D42.1 (A1), J4.1 (DAT2), R12.1, TP1.1
unnamed: D48.1 (A1), J4.8 (DAT1), R19.1, TP2.1
unnamed: D49.1 (DOUT), D50.3 (DIN)
unnamed: D50.1 (DOUT), D51.3 (DIN)
unnamed: D51.1 (DOUT), D52.3 (DIN)
unnamed: D52.1 (DOUT), D53.3 (DIN)
unnamed: D53.1 (DOUT), TP6.1
unnamed: C8.2, J1.S1 (SHIELD), R8.1
unnamed: C1.2, J4.9 (SHIELD), R22.1
unnamed: TP3.1, U3.39 (IO1)
unnamed: R7.2, TP27.1, U3.25 (IO48)
unnamed: R16.2, R17.1, U4.10 (FB)
unnamed: L5.2, U4.4 (L1)
unnamed: L5.1, U4.2 (L2)
unnamed: C28.1, U5.2 (OUT)
unnamed: R11.2, R15.1, U10.10 (FB)
unnamed: L2.2, U10.4 (L1)
unnamed: L2.1, U10.2 (L2)
unnamed: R3.2, U11.15 (I2C_ADR0), U11.16 (I2C_ADR1)
unnamed: C26.1, C27.1, R5.1, R32.2, U13.3 (+)
unnamed: R33.1, R34.2, U13.4 (-)
VBUS: C2.1, C13.1, L1.2, R28.2, U1.A2 (IN)
VDC: C6.1, C20.1, U1.B2 (SYS), U2.C2 (SRX), U4.5 (VIN), U4.6 (EN), U4.7 (PS/SYNC), U4.8 (VINA), U10.5 (VIN), U10.6 (EN), U10.7 (PS/SYNC), U10.8 (VINA)

Notes on the sheet:
Buttons
Battery Safety
I2C Pullup
Fuel Gauge
LEDs
Qwicc Connectors
5V Buck Boost
SD Card
User Buttons
Microphone Circuit
Mounting
Battery Charger
3.3V Buck Boost
Battery Connectors
USB Connector and Protection
B2B Connector
ADC
ESP32-S3

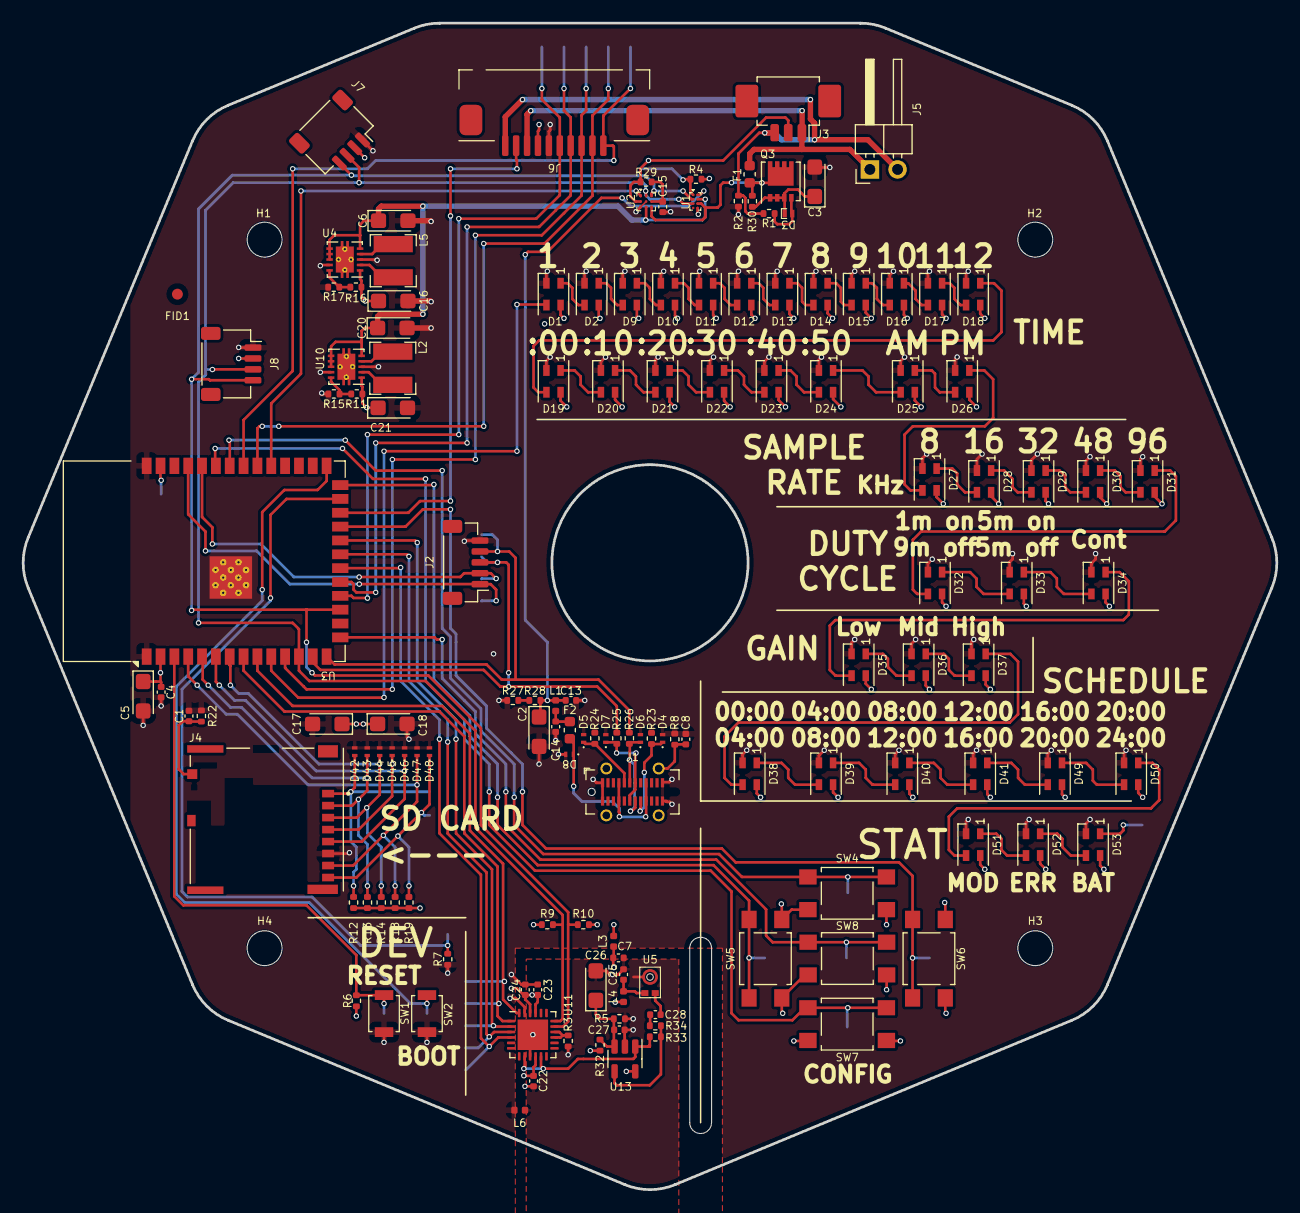
[picture p51: board IC_001 - Low Cost Audio Sensor.kicad_pcb from above]

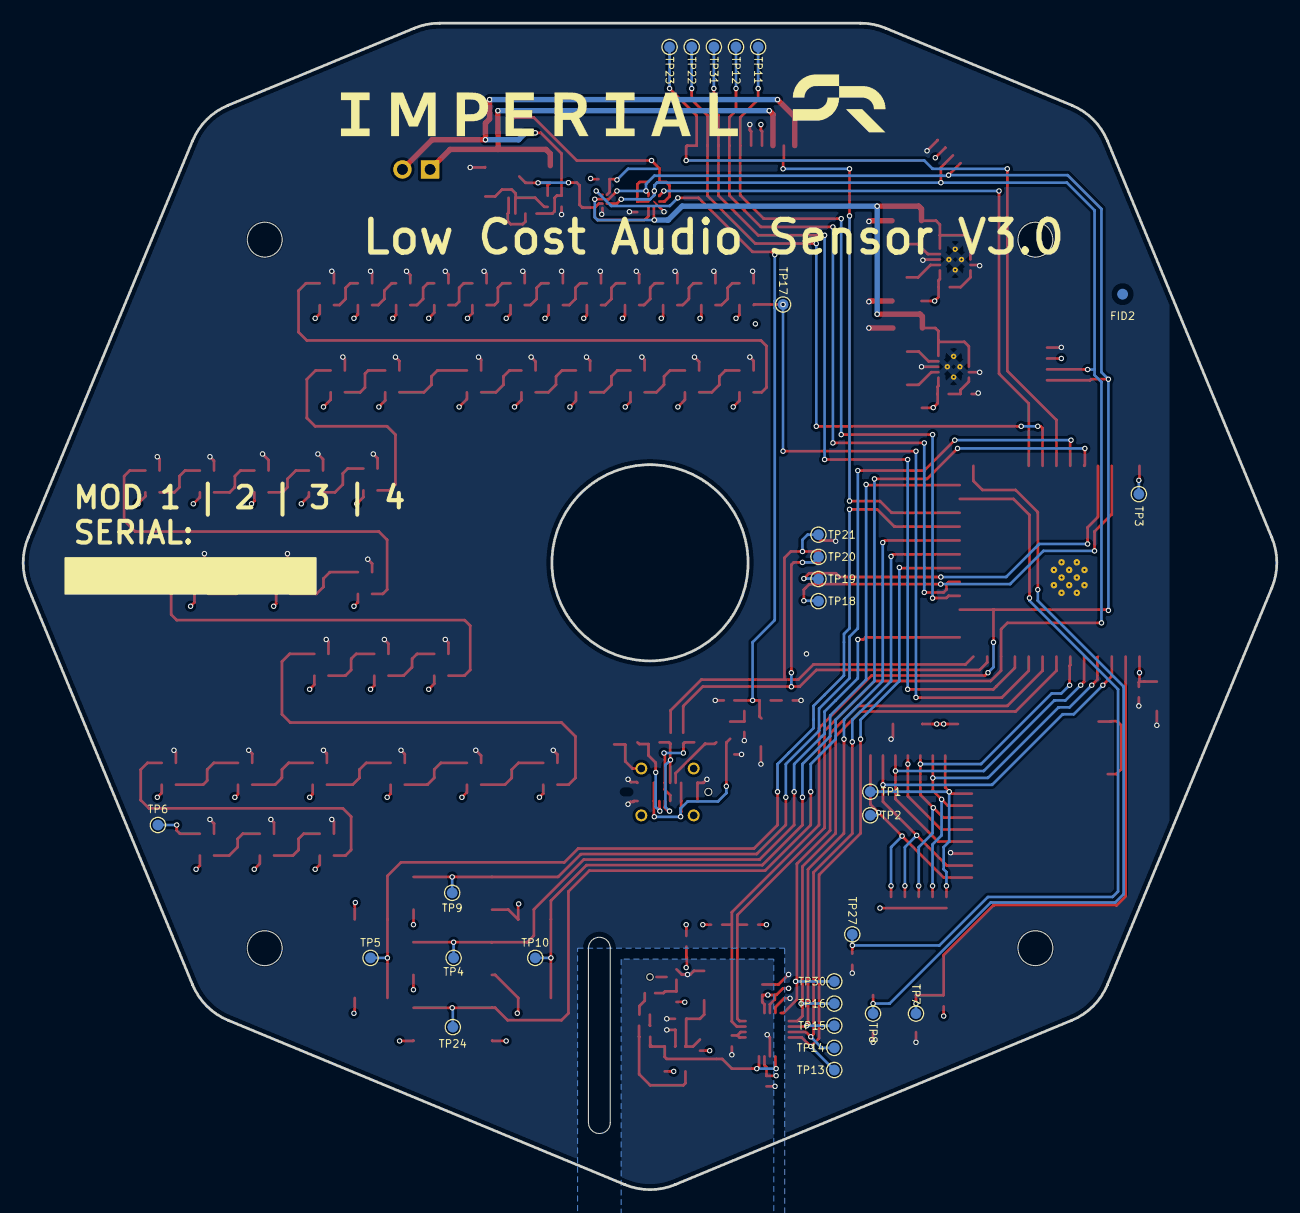
[picture p52: board IC_001 - Low Cost Audio Sensor.kicad_pcb from below]

Board: 4 copper layers, 115.0 x 107.0 mm, 172 parts (28 on the bottom side), 111 nets.
