ryanstevensmith/locust_hardware/IC_002 - Acoustic Nb-IoT Daughter Board/working/IC_002 - Acoustic Nb-IoT Daughter Board.kicad_pcb

## KiCad design IC_002 - Acoustic Nb-IoT Daughter Board/working/IC_002 - Acoustic Nb-IoT Daughter Board.kicad_pcb (2026-10-24)

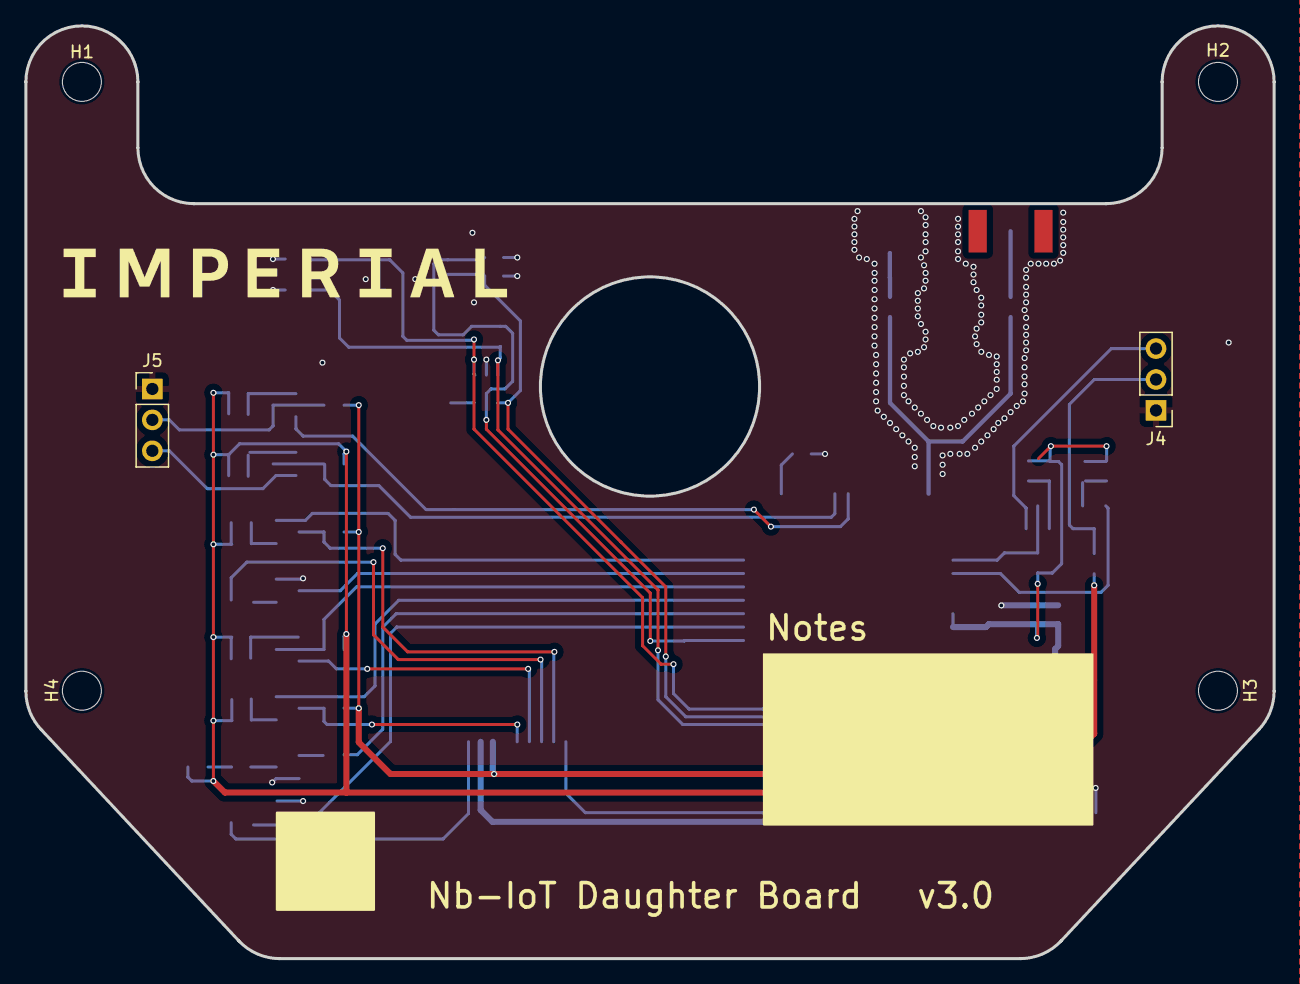
[picture p53: board IC_002 - Acoustic Nb-IoT Daughter Board.kicad_pcb from above]

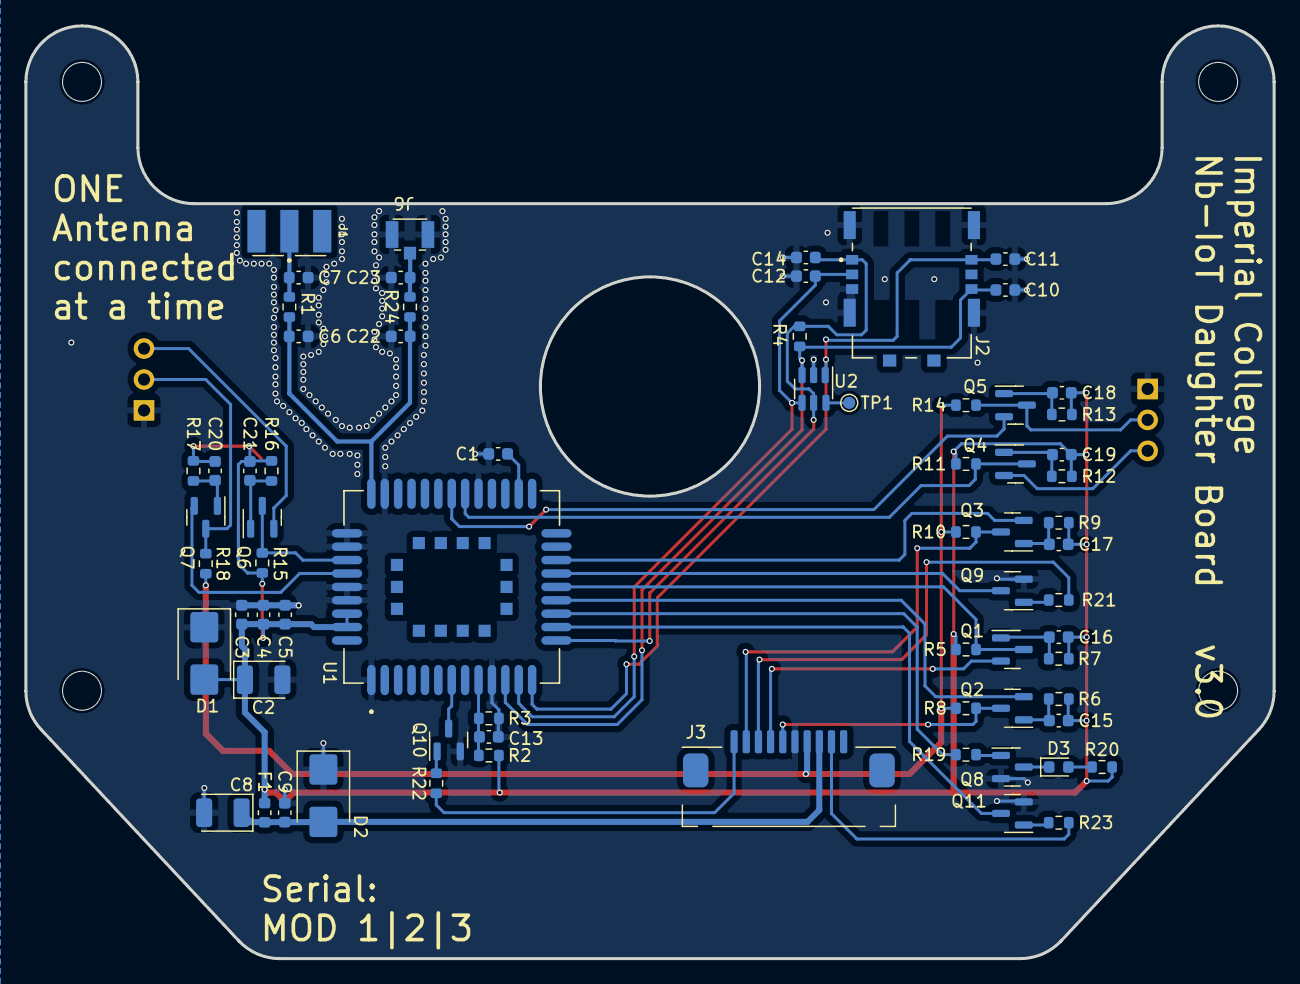
[picture p54: board IC_002 - Acoustic Nb-IoT Daughter Board.kicad_pcb from below]

Board: 2 copper layers, 102.5 x 76.6 mm, 75 parts (69 on the bottom side), 48 nets.

Parts:
C1: 2.2uF; C_0603_1608Metric
C2, C8: 100uF; CP_EIA-3528-21_Kemet-B
C3, C9, C13, C14: 100nF; C_0603_1608Metric
C4: 100pF; C_0603_1608Metric
C5, C6, C7, C10, C11, C12, C22, C23: 22pF; C_0603_1608Metric
C15, C16, C17, C18, C19, C20, C21: 1nF; C_0603_1608Metric
D1, D2: P6SMBJ5.0CA; D_SMB
D3: Blue; LED_0603_1608Metric
F1: 1A/32V; Fuse_0603_1608Metric
H1, H2, H3, H4: M3; MountingHole_3.2mm_M3
J1: SMA; CON-SMA-EDGE-S
J2: 104224-0820; MOLEX_104224-0820
J3: 52207-1060
J4, J5: Conn_01x03_Pin; PinHeader_1x03_P2.54mm_Vertical
J6: U.FL; U.FL-R-SMT-1_1
Q1, Q2, Q3, Q4, Q5, Q6, Q7, Q8, Q9, Q10, Q11: BC817; SOT-23
R1, R24: 0R; R_0603_1608Metric
R2: 21K; R_0603_1608Metric
R3, R4, R5, R8, R10, R11, R14, R15, R18: 10K; R_0603_1608Metric
R6, R7, R9, R12, R13, R16, R17: 4K7; R_0603_1608Metric
R19, R20, R21, R22, R23: 1K; R_0603_1608Metric
TP1: TestPoint; TestPoint_Pad_D1.0mm
U1: BC65
U2: SRV05-4HTG-D; TSOT-23-6

Connections:
+3V3: J3.4, R8.2, R10.2, R14.2, R18.2
+3V8: C2.1, C3.1, C4.1, C5.1, C15.2, C16.2, C17.2, C18.2, C19.2, C20.2, C21.2, D1.2 (A2), F1.1, R2.1, R5.1, R6.1, R7.1, R9.1, R11.1, R12.1, R13.1, R15.1, R16.1, R17.1, R20.2, U1.42 (VBAT), U1.43 (VBAT)
/BATT_CONN: C8.1, C9.1, D2.2 (A2), F1.2, J3.3
/BC_ADC: C13.1, R2.2, R3.1, U1.9 (ADC)
/BC_AUX_RXD: Q4.3 (C), R11.2, U1.28 (AUX_RXD)
/BC_AUX_TXD: Q5.2 (E), U1.29 (AUX_TXD)
/BC_DBG_RXD: Q6.3 (C), R15.2, U1.38 (DBG_RXD)
/BC_DBG_TXD: Q7.2 (E), U1.39 (DBG_TXD)
/BC_MAIN_RXD: Q1.3 (C), R5.2, U1.18 (MAIN_RXD)
/BC_MAIN_TXD: Q2.2 (E), U1.17 (MAIN_TXD)
/BC_NETLIGHT: R19.1, U1.16 (NETLIGHT)
/BC_PSM_ENIT: Q9.3 (C), U1.19 (PSM_EINT)
/BC_RI: Q3.2 (E), U1.20 (RI)
/BC_~PWRKEY: Q10.3 (C), U1.7 (~PWRKEY)
/BC_~RESET: Q11.3 (C), U1.15 (~RESET)
/EXT_GPIO1: J3.6, Q2.3 (C), R8.1
/EXT_GPIO2: J3.7, Q1.2 (E)
/EXT_GPIO3: J3.8, R21.1
/EXT_GPIO4: J3.9, Q3.3 (C), R10.1
/EXT_GPIO5: J3.10, R22.1
/EXT_GPIO6: J3.2, R23.1
/USIM_CLK: C11.1, J2.S3 (CLK), U1.13 (USIM_CLK), U2.1 (I/O1)
/USIM_DATA: C10.1, J2.S6 (I/O), R4.2, U1.11 (USIM_DATA), U2.3 (I/O2)
/USIM_RST: C12.1, J2.S2 (RST), U1.12 (USIM_RST), U2.4 (I/O3)
/USIM_VDD: C14.1, J2.S1 (VCC), R4.1, U1.14 (USIM_VDD), U2.5 (VCC)
/VDD_EXT: C1.1, U1.24 (VDD_EXT)
GND: C1.2, C2.2, C3.2, C4.2, C5.2, C6.2, C7.2, C8.2, C9.2, C10.2, C11.2, C12.2, C13.2, C14.2, C22.2, C23.2, D1.1 (A1), D2.1 (A1), J2.G1 (GND), J2.G2 (GND), J2.G3 (GND), J2.G4 (GND), J2.S4 (GND), J3.5, J4.1, J5.1, J6.2 (Ext), Q8.2 (E), Q9.2 (E), Q10.2 (E), Q11.2 (E), R3.2, U1.1 (GND), U1.10 (GND), U1.27 (GND), U1.34 (GND), U1.36 (GND), U1.37 (GND), U1.40 (GND), U1.41 (GND), U2.2 (GND)
unnamed: D3.2 (A), R20.1
unnamed: D3.1 (K), Q8.3 (C)
unnamed: C7.1, J1.1 (In), R1.2
unnamed: J4.2, Q7.3 (C), R18.1
unnamed: J4.3, Q6.2 (E)
unnamed: J5.2, Q5.3 (C), R14.1
unnamed: J5.3, Q4.2 (E)
unnamed: C23.1, J6.1 (In), R24.2
unnamed: C16.1, Q1.1 (B), R7.2
unnamed: C15.1, Q2.1 (B), R6.2
unnamed: C17.1, Q3.1 (B), R9.2
unnamed: C19.1, Q4.1 (B), R12.2
unnamed: C18.1, Q5.1 (B), R13.2
unnamed: C21.1, Q6.1 (B), R16.2
unnamed: C20.1, Q7.1 (B), R17.2
unnamed: Q8.1 (B), R19.2
unnamed: Q9.1 (B), R21.2
unnamed: Q10.1 (B), R22.2
unnamed: Q11.1 (B), R23.2
unnamed: C6.1, C22.1, R1.1, R24.1, U1.35 (ANT_RF)
unnamed: TP1.1, U2.6 (I/O4)
